samnadol/ROV_PCIe_USB_HUB/README.md

# PCIe USB Hub for Pi 5

# Images
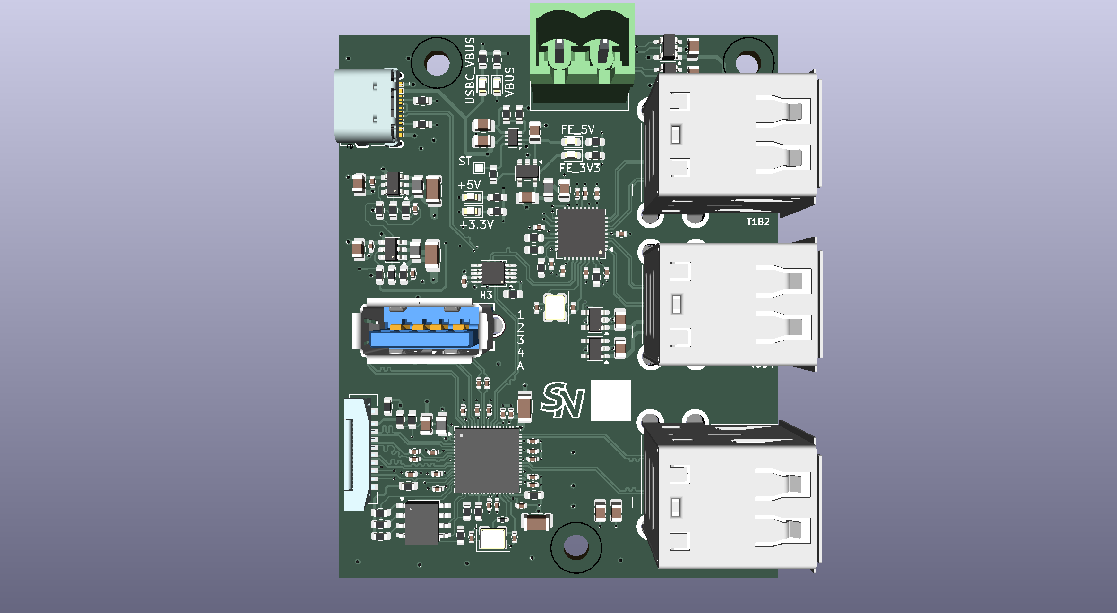
[picture p1: board_usb2514.png]
USB2514 Board
