samnadol/ROV_PCIe_USB_HUB/ROV_PCIe_USB_HUB_USB2514/parts.txt

https://www.molex.com/en-us/products/part-detail/525591652?display=pdf
https://www.pishop.us/product/pcie-flexible-cable-40mm-for-raspberry-pi-5-suitable-for-various-raspberry-pi-5-pcie-hats/

AQDYB3tn74kUOxAAGxyP+QQopcaaUm6YQ6fong==
