samnadol/ROV_PCIe_USB_HUB/ROV_PCIe_USB_HUB_FINAL/ROV_PCIE_USB_HUB_FINAL.kicad_pcb

## KiCad design ROV_PCIe_USB_HUB_FINAL/ROV_PCIE_USB_HUB_FINAL.kicad_pcb (2026-09-04)

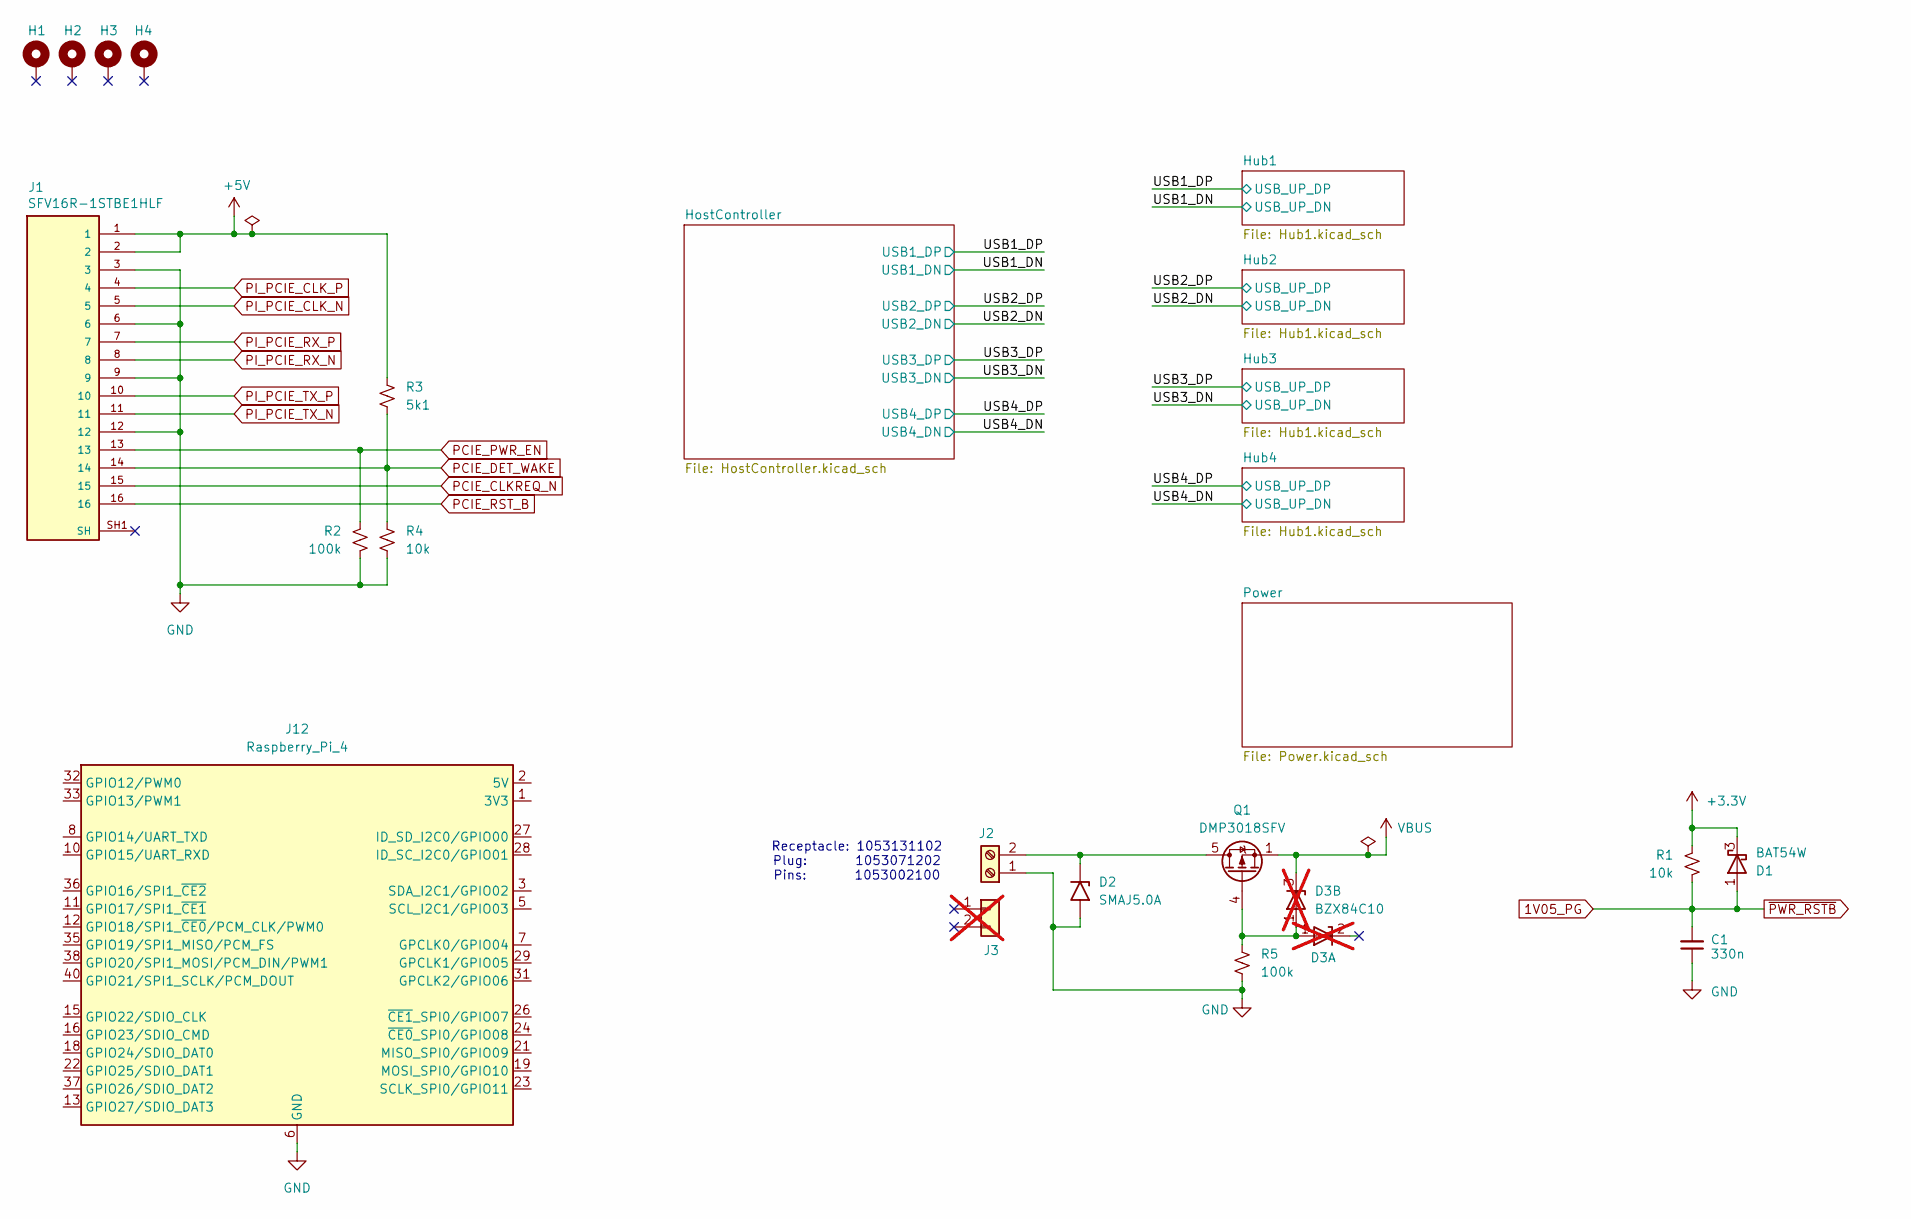
[picture p2: schematic ROV_PCIE_USB_HUB_FINAL.kicad_sch]

Parts:
C1: 330n; C_0402_1005Metric
D1: BAT54W; SOT-323_SC-70
D2: SMAJ5.0A; D_SMA; Part Number SMAJ5.0A
D3: BZX84C10; SOT-23; not fitted
H1, H2, H3, H4: MountingHole_Pad; MountingHole_2.7mm_M2.5_Pad
J1: SFV16R-1STBE1HLF; AMPHENOL_SFV16R-1STBE1HLF; PARTREV B
J2: 1053131102; Part Number 1053131102
J3: 1053071202; Part Number 1053071202; not fitted
J12: Raspberry_Pi_4; PinSocket_2x20_P2.54mm_Vertical
Q1: DMP3018SFV; Diodes_PowerDI3333-8; Part Number DMP3018SFV
R1, R4: 10k; R_0603_1608Metric
R2: 100k; R_0603_1608Metric
R3: 5k1; R_0603_1608Metric
R5: 100k; R_0603_1608Metric; Part Number RC0603FR-07100KL

Connections:
1V05_PG: C1.2, D1.1 (A), R1.2; also elsewhere on the board
+3.3V: D1.3 (K), R1.1; also elsewhere on the board
+5V: J1.1, J1.2, R3.1; also elsewhere on the board
GND: C1.1, D2.2 (A2), J1.3, J1.6, J1.9, J1.12, J2.1, J12.6 (GND), J12.9 (GND), J12.14 (GND), J12.20 (GND), J12.25 (GND), J12.30 (GND), J12.34 (GND), J12.39 (GND), R2.2, R4.2, R5.2; also elsewhere on the board
unnamed: D2.1 (A1), J2.2, Q1.5 (D)
unnamed: D3.1 (A), Q1.4 (G), R5.1
unnamed: J12.1 (3V3), J12.17 (3V3)
unnamed: J12.2 (5V), J12.4 (5V)
PCIE_CLKREQ_N: J1.15; also elsewhere on the board
PCIE_DET_WAKE: J1.14, R3.2, R4.1; also elsewhere on the board
PCIE_PWR_EN: J1.13, R2.1; also elsewhere on the board
PCIE_RST_B: J1.16; also elsewhere on the board
PI_PCIE_CLK_N: J1.5; also elsewhere on the board
PI_PCIE_CLK_P: J1.4; also elsewhere on the board
PI_PCIE_RX_N: J1.8; also elsewhere on the board
PI_PCIE_RX_P: J1.7; also elsewhere on the board
PI_PCIE_TX_N: J1.11; also elsewhere on the board
PI_PCIE_TX_P: J1.10; also elsewhere on the board
VBUS: D3.3 (K), Q1.1 (S), Q1.2 (S), Q1.3 (S); also elsewhere on the board

Notes on the sheet:
Receptacle: 1053131102 Plug: 1053071202 Pins: 1053002100

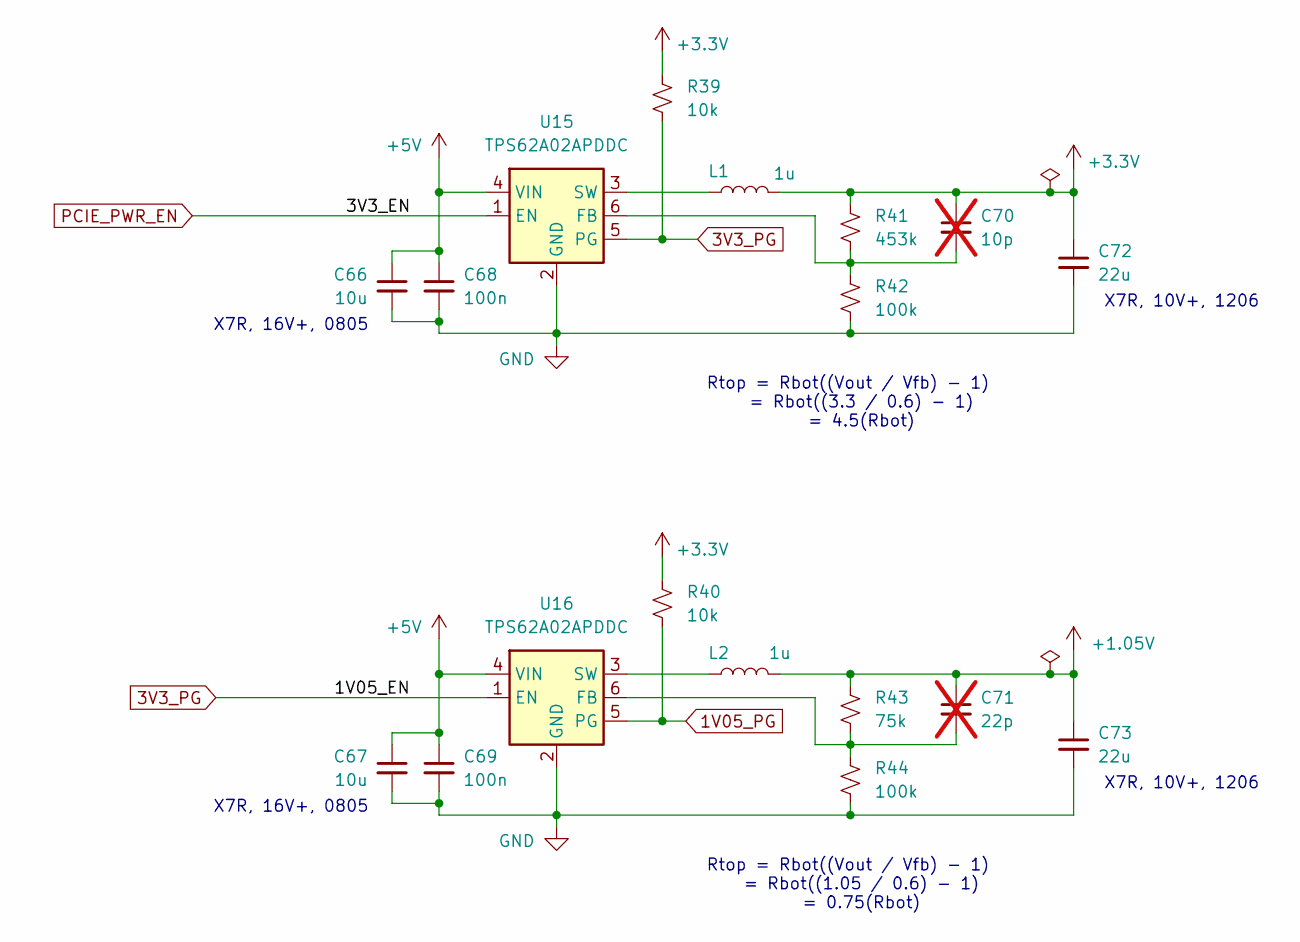
[picture p3: schematic Power.kicad_sch]

Parts:
C66, C67: 10u; C_0805_2012Metric; Part Number CC0805KRX5R8BB106
C68, C69: 100n; C_0402_1005Metric; Part Number CC0402KRX7R8BB104
C70: 10p; C_0402_1005Metric; Part Number CL05C100JB5NNNC; not fitted
C71: 22p; C_0402_1005Metric; Part Number CL05C220JB5NNNC; not fitted
C72, C73: 22u; C_1206_3216Metric; Part Number CC1206KKX5R8BB226
L1, L2: 1u; L_1008_2520Metric; Part Number DFE252012F-1R0M
R39, R40: 10k; R_0603_1608Metric; Part Number RC0603FR-0710KL
R41: 453k; R_0603_1608Metric; Part Number RC0603FR-07453KL
R42, R44: 100k; R_0603_1608Metric; Part Number RC0603FR-07100KL
R43: 75k; R_0603_1608Metric; Part Number RC0603FR-0775KL
U15, U16: TPS62A02APDDC; SOT-23-6; Part Number TPS62A02APDDC

Connections:
1V05_PG: R40.2, U16.5 (PG); also elsewhere on the board
3V3_PG: R39.2, U15.5 (PG), U16.1 (EN)
+1.05V: C71.1, C73.1, L2.2, R43.1; also elsewhere on the board
+3.3V: C70.1, C72.1, L1.2, R39.1, R40.1, R41.1; also elsewhere on the board
+5V: C66.1, C67.1, C68.1, C69.1, U15.4 (VIN), U16.4 (VIN); also elsewhere on the board
GND: C66.2, C67.2, C68.2, C69.2, C72.2, C73.2, R42.2, R44.2, U15.2 (GND), U16.2 (GND); also elsewhere on the board
unnamed: C70.2, R41.2, R42.1, U15.6 (FB)
unnamed: L1.1, U15.3 (SW)
unnamed: C71.2, R43.2, R44.1, U16.6 (FB)
unnamed: L2.1, U16.3 (SW)
PCIE_PWR_EN: U15.1 (EN); also elsewhere on the board

Notes on the sheet:
X7R, 10V+, 1206
Rtop = Rbot((Vout / Vfb) - 1) = Rbot((1.05 / 0.6) - 1) = 0.75(Rbot)
Rtop = Rbot((Vout / Vfb) - 1) = Rbot((3.3 / 0.6) - 1) = 4.5(Rbot)
X7R, 16V+, 0805

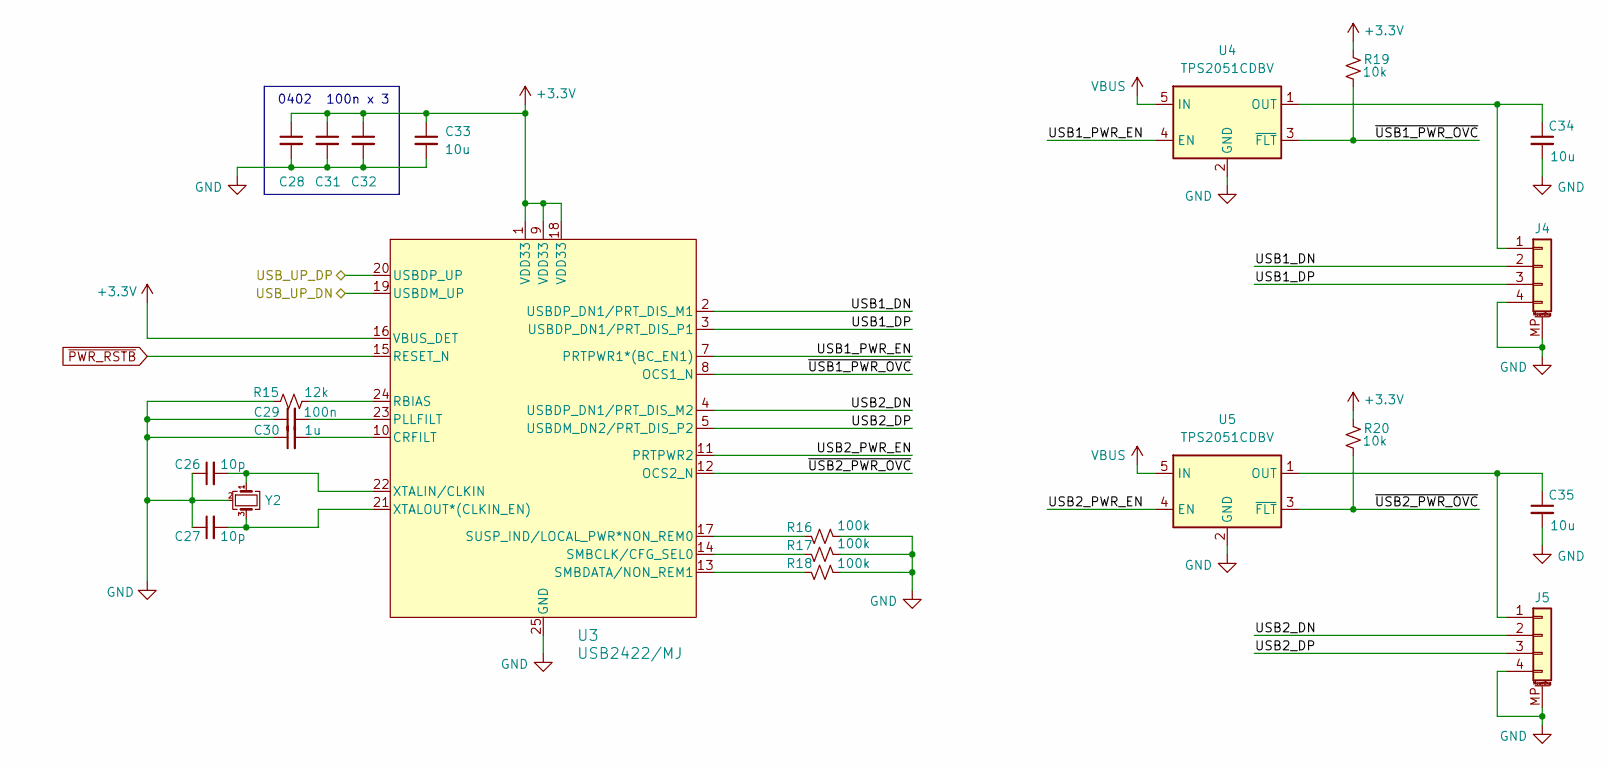
[picture p4: schematic Hub1.kicad_sch]

Parts:
C26, C27: 10p; C_0402_1005Metric
C28, C29, C31, C32: 100n; C_0402_1005Metric
C30: 1u; C_0603_1608Metric
C33: 10u; C_0805_2012Metric
C34, C35: 10u; C_0805_2012Metric; Part Number CC0805KRX5R8BB106
J4, J5: SM04B-SRSS-TB; JST_SH_SM04B-SRSS-TB_1x04-1MP_P1.00mm_Horizontal
R15: 12k; R_0603_1608Metric
R16, R17, R18: 100k; R_0603_1608Metric
R19, R20: 10k; R_0402_1005Metric
U3: USB2422/MJ; QFN-24-1EP_4x4mm_P0.5mm_EP2.5x2.5mm_ThermalVias
U4, U5: TPS2051CDBV; SOT-23-5
Y2: ECS-240-8-37B-CKY-TR; Crystal_SMD_2016-4Pin_2.0x1.6mm

Connections:
1V05_PG: U3.15 (RESET_N); also elsewhere on the board
+3.3V: C28.1, C31.1, C32.1, C33.1, R19.1, R20.1, U3.1 (VDD33), U3.9 (VDD33), U3.16 (VBUS_DET), U3.18 (VDD33); also elsewhere on the board
/Hub1/USB1_DN: J4.2, U3.2 (USBDP_DN1/PRT_DIS_M1)
/Hub1/USB1_DP: J4.3, U3.3 (USBDP_DN1/PRT_DIS_P1)
/Hub1/USB1_PWR_EN: U3.7 (PRTPWR1*(BC_EN1)), U4.4 (EN)
/Hub1/USB2_DN: J5.2, U3.4 (USBDP_DN1/PRT_DIS_M2)
/Hub1/USB2_DP: J5.3, U3.5 (USBDM_DN2/PRT_DIS_P2)
/Hub1/USB2_PWR_EN: U3.11 (PRTPWR2), U5.4 (EN)
/Hub1/~USB1_PWR_OVC: R19.2, U3.8 (OCS1_N), U4.3 (~FLT)
/Hub1/~USB2_PWR_OVC: R20.2, U3.12 (OCS2_N), U5.3 (~FLT)
/USB1_DN: U3.19 (USBDM_UP); also elsewhere on the board
/USB1_DP: U3.20 (USBDP_UP); also elsewhere on the board
GND: C26.1, C27.1, C28.2, C29.1, C30.1, C31.2, C32.2, C33.2, C34.2, C35.2, J4.4, J4.MP (MountPin), J5.4, J5.MP (MountPin), R15.1, R16.2, R17.2, R18.2, U3.25 (GND), U4.2 (GND), U5.2 (GND), Y2.2 (G), Y2.4 (G); also elsewhere on the board
unnamed: C34.1, J4.1, U4.1 (OUT)
unnamed: C35.1, J5.1, U5.1 (OUT)
unnamed: C30.2, U3.10 (CRFILT)
unnamed: C29.2, U3.23 (PLLFILT)
unnamed: R15.2, U3.24 (RBIAS)
unnamed: R17.1, U3.14 (SMBCLK/CFG_SEL0)
unnamed: R18.1, U3.13 (SMBDATA/NON_REM1)
unnamed: R16.1, U3.17 (SUSP_IND/LOCAL_PWR*NON_REM0)
unnamed: C26.2, U3.22 (XTALIN/CLKIN), Y2.1
unnamed: C27.2, U3.21 (XTALOUT*(CLKIN_EN)), Y2.3
VBUS: U4.5 (IN), U5.5 (IN); also elsewhere on the board

Parts of its further copies:
C36, C37, C46, C47, C56, C57: 10p; C_0402_1005Metric
C38, C39, C41, C42, C48, C49, C51, C52, C58, C59, C61, C62: 100n; C_0402_1005Metric
C40, C50, C60: 1u; C_0603_1608Metric
C43, C53, C63: 10u; C_0805_2012Metric
C44, C45, C54, C55, C64, C65: 10u; C_0805_2012Metric; Part Number CC0805KRX5R8BB106
J6, J7, J8, J9, J10, J11: SM04B-SRSS-TB; JST_SH_SM04B-SRSS-TB_1x04-1MP_P1.00mm_Horizontal
R21, R27, R33: 12k; R_0603_1608Metric
R22, R23, R24, R28, R29, R30, R34, R35, R36: 100k; R_0603_1608Metric
R25, R26, R31, R32, R37, R38: 10k; R_0402_1005Metric
U6, U9, U12: USB2422/MJ; QFN-24-1EP_4x4mm_P0.5mm_EP2.5x2.5mm_ThermalVias
U7, U8, U10, U11, U13, U14: TPS2051CDBV; SOT-23-5
Y3, Y4, Y5: ECS-240-8-37B-CKY-TR; Crystal_SMD_2016-4Pin_2.0x1.6mm

Connections of its further copies:
1V05_PG: U6.15 (RESET_N), U9.15 (RESET_N), U12.15 (RESET_N); also elsewhere on the board
+3.3V: C38.1, C41.1, C42.1, C43.1, C48.1, C51.1, C52.1, C53.1, C58.1, C61.1, C62.1, C63.1, R25.1, R26.1, R31.1, R32.1, R37.1, R38.1, U6.1 (VDD33), U6.9 (VDD33), U6.16 (VBUS_DET), U6.18 (VDD33), U9.1 (VDD33), U9.9 (VDD33), U9.16 (VBUS_DET), U9.18 (VDD33), U12.1 (VDD33), U12.9 (VDD33), U12.16 (VBUS_DET), U12.18 (VDD33); also elsewhere on the board
/Hub2/USB1_DN: J6.2, U6.2 (USBDP_DN1/PRT_DIS_M1)
/Hub2/USB1_DP: J6.3, U6.3 (USBDP_DN1/PRT_DIS_P1)
/Hub2/USB1_PWR_EN: U6.7 (PRTPWR1*(BC_EN1)), U7.4 (EN)
/Hub2/USB2_DN: J7.2, U6.4 (USBDP_DN1/PRT_DIS_M2)
/Hub2/USB2_DP: J7.3, U6.5 (USBDM_DN2/PRT_DIS_P2)
/Hub2/USB2_PWR_EN: U6.11 (PRTPWR2), U8.4 (EN)
/Hub2/~USB1_PWR_OVC: R25.2, U6.8 (OCS1_N), U7.3 (~FLT)
/Hub2/~USB2_PWR_OVC: R26.2, U6.12 (OCS2_N), U8.3 (~FLT)
/Hub3/USB1_DN: J8.2, U9.2 (USBDP_DN1/PRT_DIS_M1)
/Hub3/USB1_DP: J8.3, U9.3 (USBDP_DN1/PRT_DIS_P1)
/Hub3/USB1_PWR_EN: U9.7 (PRTPWR1*(BC_EN1)), U10.4 (EN)
/Hub3/USB2_DN: J9.2, U9.4 (USBDP_DN1/PRT_DIS_M2)
/Hub3/USB2_DP: J9.3, U9.5 (USBDM_DN2/PRT_DIS_P2)
/Hub3/USB2_PWR_EN: U9.11 (PRTPWR2), U11.4 (EN)
/Hub3/~USB1_PWR_OVC: R31.2, U9.8 (OCS1_N), U10.3 (~FLT)
/Hub3/~USB2_PWR_OVC: R32.2, U9.12 (OCS2_N), U11.3 (~FLT)
/Hub4/USB1_DN: J10.2, U12.2 (USBDP_DN1/PRT_DIS_M1)
/Hub4/USB1_DP: J10.3, U12.3 (USBDP_DN1/PRT_DIS_P1)
/Hub4/USB1_PWR_EN: U12.7 (PRTPWR1*(BC_EN1)), U13.4 (EN)
/Hub4/USB2_DN: J11.2, U12.4 (USBDP_DN1/PRT_DIS_M2)
/Hub4/USB2_DP: J11.3, U12.5 (USBDM_DN2/PRT_DIS_P2)
/Hub4/USB2_PWR_EN: U12.11 (PRTPWR2), U14.4 (EN)
/Hub4/~USB1_PWR_OVC: R37.2, U12.8 (OCS1_N), U13.3 (~FLT)
/Hub4/~USB2_PWR_OVC: R38.2, U12.12 (OCS2_N), U14.3 (~FLT)
/USB2_DN: U6.19 (USBDM_UP); also elsewhere on the board
/USB2_DP: U6.20 (USBDP_UP); also elsewhere on the board
/USB3_DN: U9.19 (USBDM_UP); also elsewhere on the board
/USB3_DP: U9.20 (USBDP_UP); also elsewhere on the board
/USB4_DN: U12.19 (USBDM_UP); also elsewhere on the board
/USB4_DP: U12.20 (USBDP_UP); also elsewhere on the board
GND: C36.1, C37.1, C38.2, C39.1, C40.1, C41.2, C42.2, C43.2, C44.2, C45.2, C46.1, C47.1, C48.2, C49.1, C50.1, C51.2, C52.2, C53.2, C54.2, C55.2, C56.1, C57.1, C58.2, C59.1, C60.1, C61.2, C62.2, C63.2, C64.2, C65.2, J6.4, J6.MP (MountPin), J7.4, J7.MP (MountPin), J8.4, J8.MP (MountPin), J9.4, J9.MP (MountPin), J10.4, J10.MP (MountPin), J11.4, J11.MP (MountPin), R21.1, R22.2, R23.2, R24.2, R27.1, R28.2, R29.2, R30.2, R33.1, R34.2, R35.2, R36.2, U6.25 (GND), U7.2 (GND), U8.2 (GND), U9.25 (GND), U10.2 (GND), U11.2 (GND), U12.25 (GND), U13.2 (GND), U14.2 (GND), Y3.2 (G), Y3.4 (G), Y4.2 (G), Y4.4 (G), Y5.2 (G), Y5.4 (G); also elsewhere on the board
unnamed: C44.1, J6.1, U7.1 (OUT)
unnamed: C45.1, J7.1, U8.1 (OUT)
unnamed: C54.1, J8.1, U10.1 (OUT)
unnamed: C55.1, J9.1, U11.1 (OUT)
unnamed: C64.1, J10.1, U13.1 (OUT)
unnamed: C65.1, J11.1, U14.1 (OUT)
unnamed: C40.2, U6.10 (CRFILT)
unnamed: C39.2, U6.23 (PLLFILT)
unnamed: R21.2, U6.24 (RBIAS)
unnamed: R23.1, U6.14 (SMBCLK/CFG_SEL0)
unnamed: R24.1, U6.13 (SMBDATA/NON_REM1)
unnamed: R22.1, U6.17 (SUSP_IND/LOCAL_PWR*NON_REM0)
unnamed: C36.2, U6.22 (XTALIN/CLKIN), Y3.1
unnamed: C37.2, U6.21 (XTALOUT*(CLKIN_EN)), Y3.3
unnamed: C50.2, U9.10 (CRFILT)
unnamed: C49.2, U9.23 (PLLFILT)
unnamed: R27.2, U9.24 (RBIAS)
unnamed: R29.1, U9.14 (SMBCLK/CFG_SEL0)
unnamed: R30.1, U9.13 (SMBDATA/NON_REM1)
unnamed: R28.1, U9.17 (SUSP_IND/LOCAL_PWR*NON_REM0)
unnamed: C46.2, U9.22 (XTALIN/CLKIN), Y4.1
unnamed: C47.2, U9.21 (XTALOUT*(CLKIN_EN)), Y4.3
unnamed: C60.2, U12.10 (CRFILT)
unnamed: C59.2, U12.23 (PLLFILT)
unnamed: R33.2, U12.24 (RBIAS)
unnamed: R35.1, U12.14 (SMBCLK/CFG_SEL0)
unnamed: R36.1, U12.13 (SMBDATA/NON_REM1)
unnamed: R34.1, U12.17 (SUSP_IND/LOCAL_PWR*NON_REM0)
unnamed: C56.2, U12.22 (XTALIN/CLKIN), Y5.1
unnamed: C57.2, U12.21 (XTALOUT*(CLKIN_EN)), Y5.3
VBUS: U7.5 (IN), U8.5 (IN), U10.5 (IN), U11.5 (IN), U13.5 (IN), U14.5 (IN); also elsewhere on the board

Notes on the sheet:
0402
100n x 3

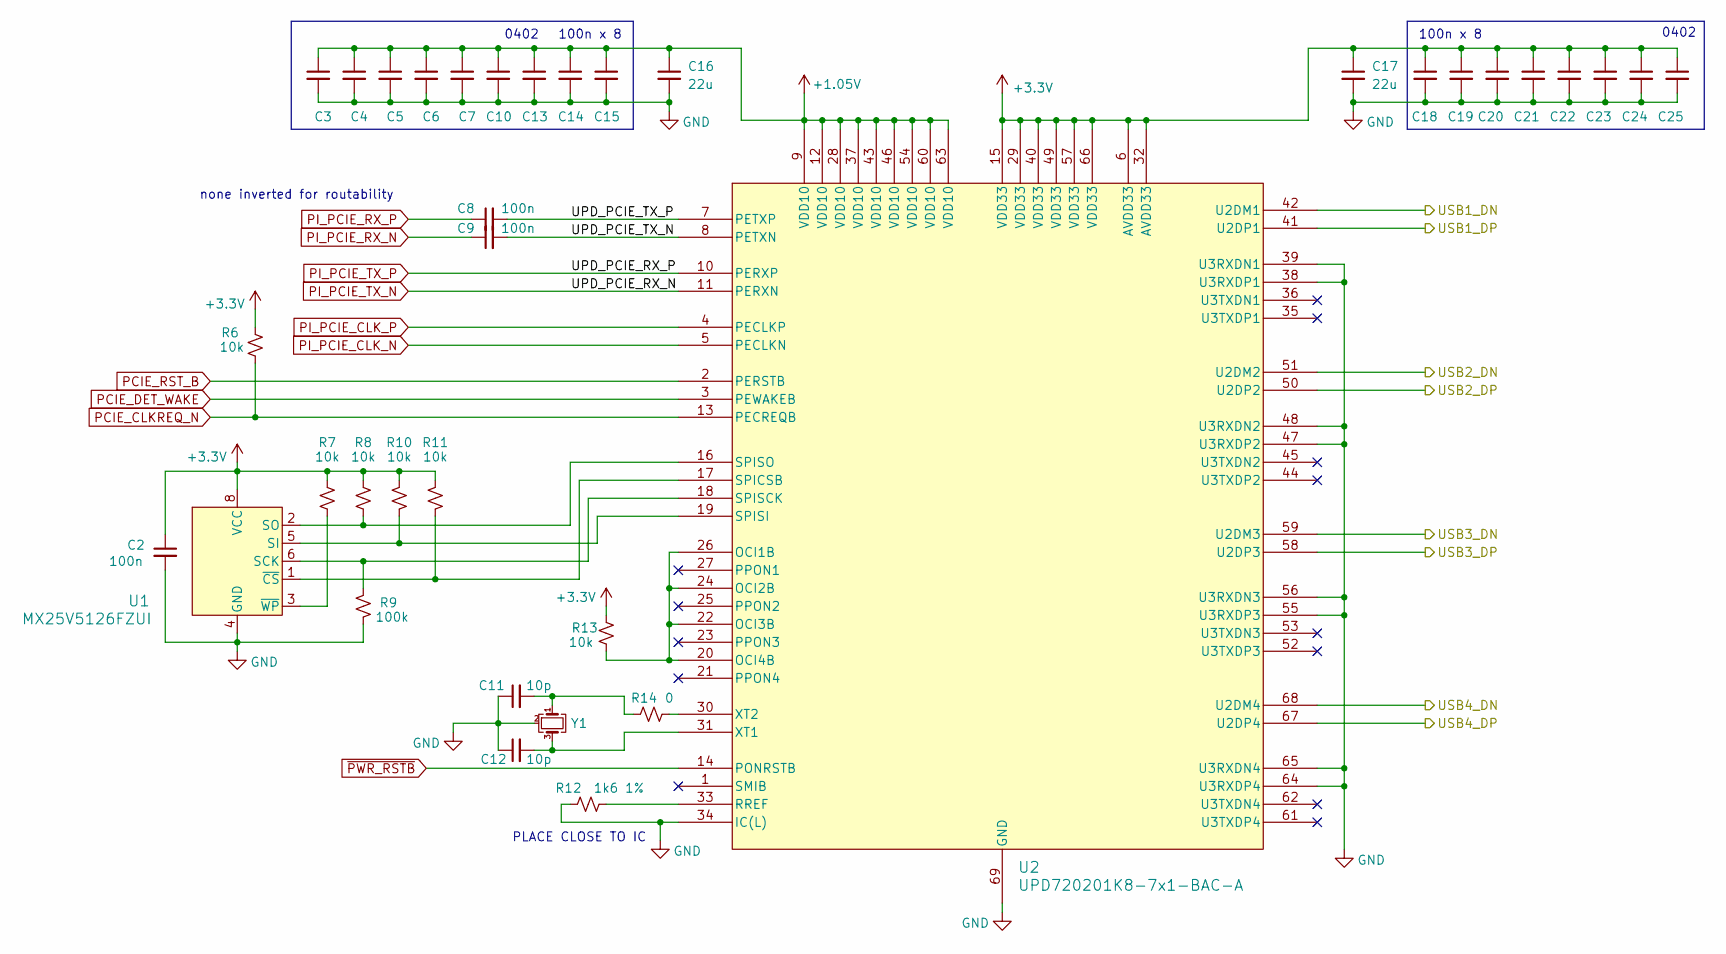
[picture p5: schematic HostController.kicad_sch]

Parts:
C2, C3, C4, C5, C6, C7, C8, C9, C10, C13, C14, C15, C18, C19, C20, C21, C22, C23, C24, C25: 100n; C_0402_1005Metric
C11, C12: 10p; C_0402_1005Metric
C16, C17: 22u; C_1206_3216Metric
R6, R7, R8, R10, R11, R13: 10k; R_0402_1005Metric
R9: 100k; R_0603_1608Metric
R12: 1k6 1%; R_0603_1608Metric
R14: 0; R_0402_1005Metric
U1: MX25V5126FZUI; Winbond_USON-8-1EP_3x2mm_P0.5mm_EP0.2x1.6mm
U2: UPD720201K8-7x1-BAC-A; QFN-68-1EP_8x8mm_P0.4mm_EP6.2x6.2mm
Y1: ECS-240-8-37B-CKY-TR; Crystal_SMD_2016-4Pin_2.0x1.6mm

Connections:
1V05_PG: U2.14 (PONRSTB); also elsewhere on the board
+1.05V: C3.1, C4.1, C5.1, C6.1, C7.1, C10.1, C13.1, C14.1, C15.1, C16.1, U2.9 (VDD10), U2.12 (VDD10), U2.28 (VDD10), U2.37 (VDD10), U2.43 (VDD10), U2.46 (VDD10), U2.54 (VDD10), U2.60 (VDD10), U2.63 (VDD10); also elsewhere on the board
+3.3V: C2.1, C17.1, C18.1, C19.1, C20.1, C21.1, C22.1, C23.1, C24.1, C25.1, R6.1, R7.1, R8.1, R10.1, R11.1, R13.1, U1.8 (VCC), U2.6 (AVDD33), U2.15 (VDD33), U2.29 (VDD33), U2.32 (AVDD33), U2.40 (VDD33), U2.49 (VDD33), U2.57 (VDD33), U2.66 (VDD33); also elsewhere on the board
/HostController/UPD_PCIE_TX_N: C9.2, U2.8 (PETXN)
/HostController/UPD_PCIE_TX_P: C8.2, U2.7 (PETXP)
/USB1_DN: U2.42 (U2DM1); also elsewhere on the board
/USB1_DP: U2.41 (U2DP1); also elsewhere on the board
/USB2_DN: U2.51 (U2DM2); also elsewhere on the board
/USB2_DP: U2.50 (U2DP2); also elsewhere on the board
/USB3_DN: U2.59 (U2DM3); also elsewhere on the board
/USB3_DP: U2.58 (U2DP3); also elsewhere on the board
/USB4_DN: U2.68 (U2DM4); also elsewhere on the board
/USB4_DP: U2.67 (U2DP4); also elsewhere on the board
GND: C2.2, C3.2, C4.2, C5.2, C6.2, C7.2, C10.2, C11.1, C12.1, C13.2, C14.2, C15.2, C16.2, C17.2, C18.2, C19.2, C20.2, C21.2, C22.2, C23.2, C24.2, C25.2, R9.2, R12.1, U1.4 (GND), U1.9 (EP), U2.34 (IC(L)), U2.38 (U3RXDP1), U2.39 (U3RXDN1), U2.47 (U3RXDP2), U2.48 (U3RXDN2), U2.55 (U3RXDP3), U2.56 (U3RXDN3), U2.64 (U3RXDP4), U2.65 (U3RXDN4), U2.69 (GND), Y1.2 (G), Y1.4 (G); also elsewhere on the board
unnamed: C11.2, R14.1, Y1.1
unnamed: R9.1, U1.6 (SCK), U2.18 (SPISCK)
unnamed: R10.2, U1.5 (SI), U2.19 (SPISI)
unnamed: R8.2, U1.2 (SO), U2.16 (SPISO)
unnamed: R11.2, U1.1 (~CS), U2.17 (SPICSB)
unnamed: R7.2, U1.3 (~WP)
unnamed: R13.2, U2.20 (OCI4B), U2.22 (OCI3B), U2.24 (OCI2B), U2.26 (OCI1B)
unnamed: R12.2, U2.33 (RREF)
unnamed: C12.2, U2.31 (XT1), Y1.3
unnamed: R14.2, U2.30 (XT2)
PCIE_CLKREQ_N: R6.2, U2.13 (PECREQB); also elsewhere on the board
PCIE_DET_WAKE: U2.3 (PEWAKEB); also elsewhere on the board
PCIE_RST_B: U2.2 (PERSTB); also elsewhere on the board
PI_PCIE_CLK_N: U2.5 (PECLKN); also elsewhere on the board
PI_PCIE_CLK_P: U2.4 (PECLKP); also elsewhere on the board
PI_PCIE_RX_N: C9.1; also elsewhere on the board
PI_PCIE_RX_P: C8.1; also elsewhere on the board
PI_PCIE_TX_N: U2.11 (PERXN); also elsewhere on the board
PI_PCIE_TX_P: U2.10 (PERXP); also elsewhere on the board

Notes on the sheet:
100n x 8
0402
none inverted for routability
PLACE CLOSE TO IC

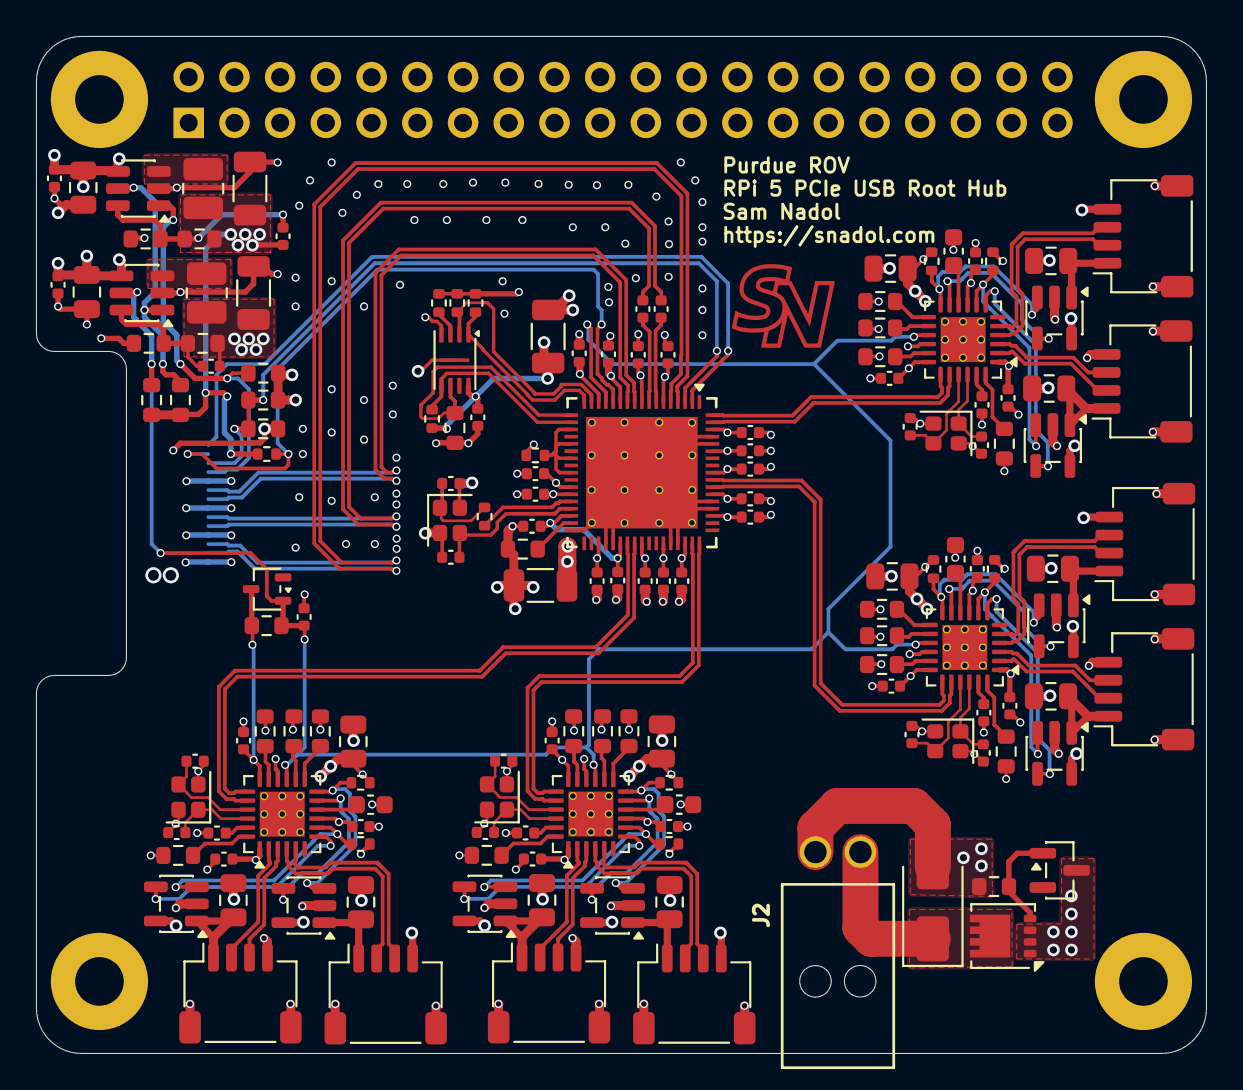
[picture p6: board ROV_PCIE_USB_HUB_FINAL.kicad_pcb from above]

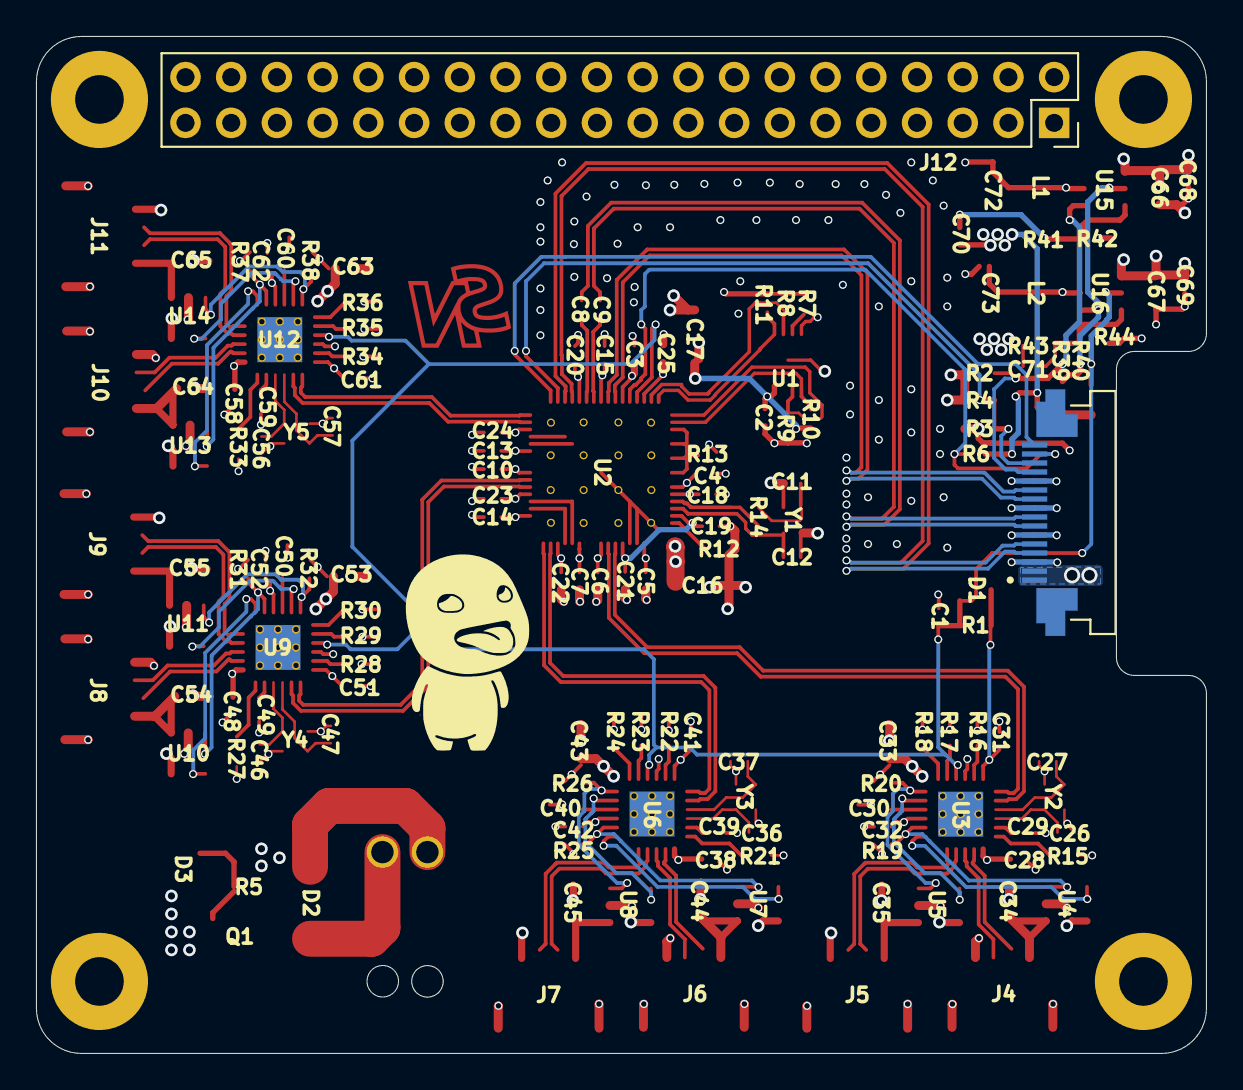
[picture p7: board ROV_PCIE_USB_HUB_FINAL.kicad_pcb from below]

Board: 4 copper layers, 65.0 x 56.5 mm, 159 parts (2 on the bottom side), 117 nets.
