samnadol/ROV_PCIe_USB_HUB/ROV_PCIe_USB_HUB_USB2514/rov_usb.kicad_pcb

## KiCad design ROV_PCIe_USB_HUB_USB2514/rov_usb.kicad_pcb (2026-08-31)

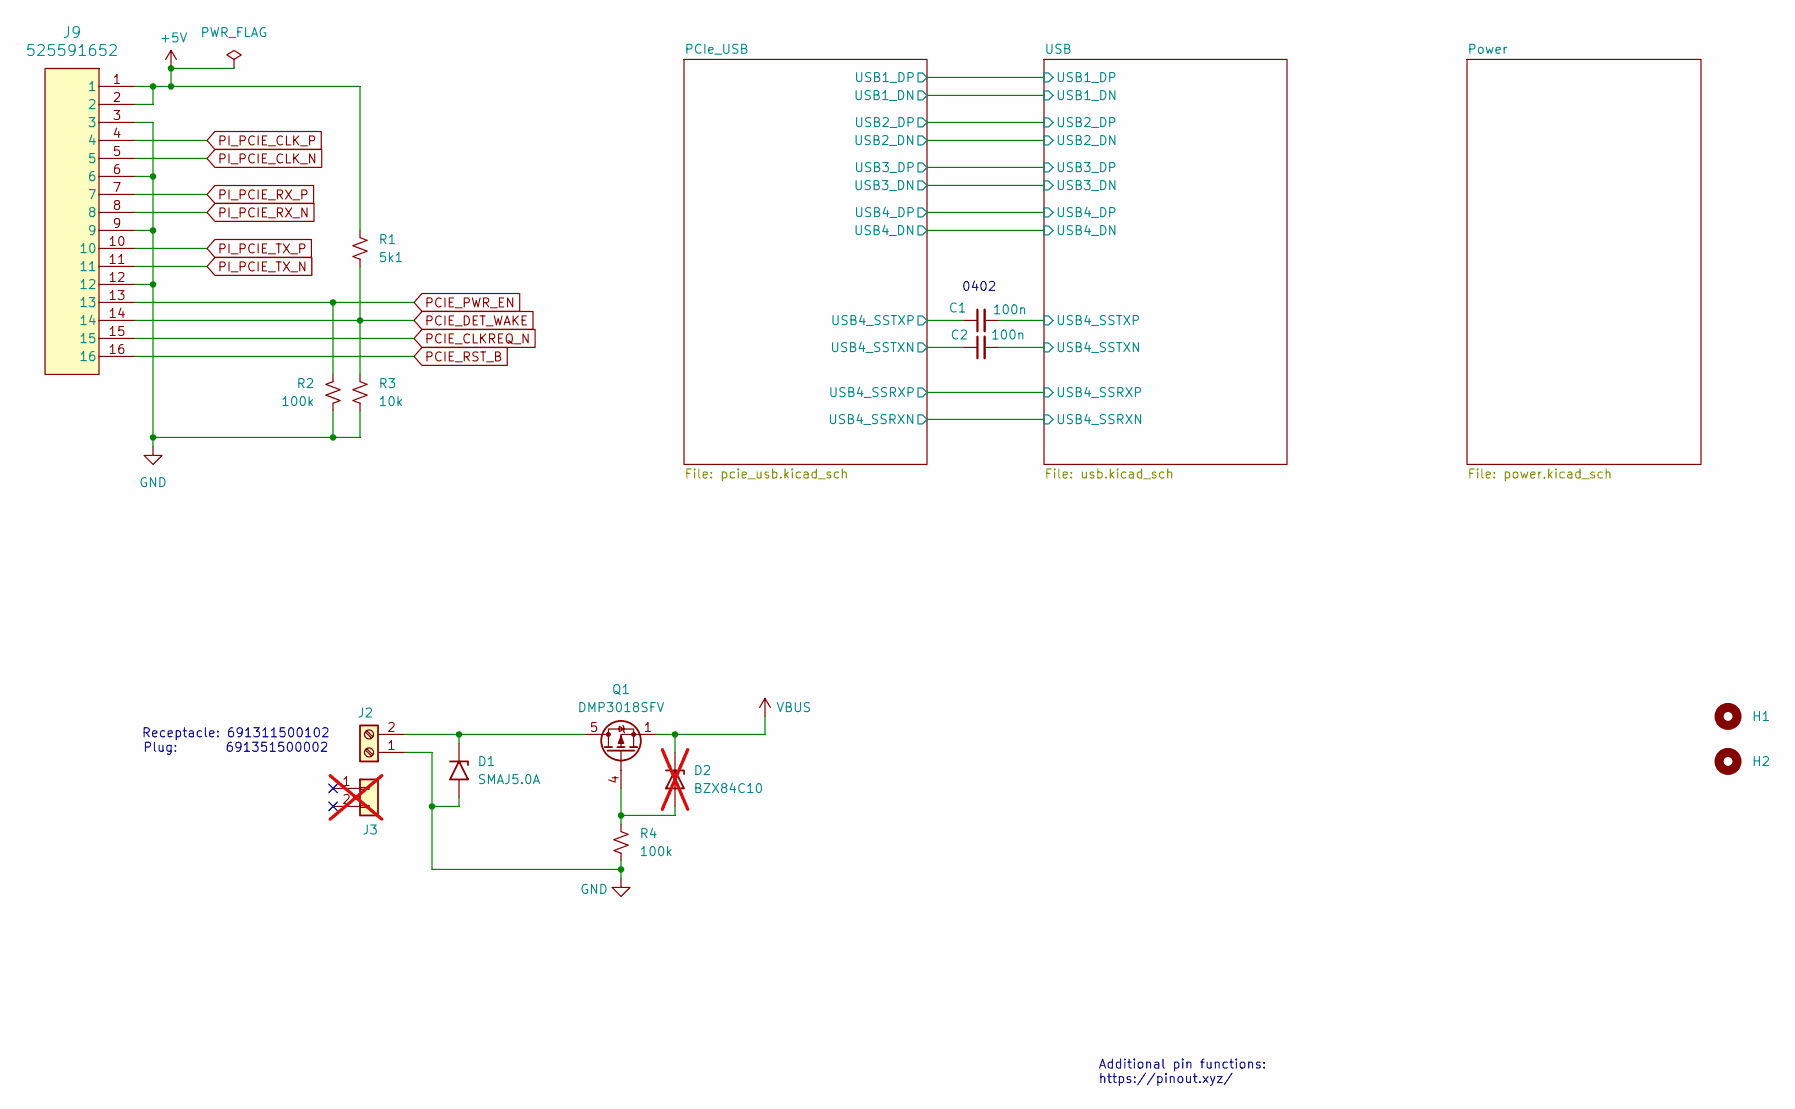
[picture p8: schematic rov_usb.kicad_sch]

Parts:
C1, C2: 100n; C_0402_1005Metric; Part Number CC0402KRX7R8BB104
D1: SMAJ5.0A; D_SMA; Part Number SMAJ5.0A
D2: BZX84C10; D_0402_1005Metric; not fitted
H1, H2: MountingHole; MountingHole_3.2mm_M3
J2: 691311500102; J_Wurth_WR-TBL_691311500102; Part Number 691311500102
J3: 691351500002; Part Number 691351500002; not fitted
J9: 525591652
Q1: DMP3018SFV; Diodes_PowerDI3333-8; Part Number DMP3018SFV
R1: 5k1; R_0603_1608Metric; Part Number RC0603FR-075K1L
R2, R4: 100k; R_0603_1608Metric; Part Number RC0603FR-07100KL
R3: 10k; R_0603_1608Metric; Part Number RC0603FR-0710KL

Connections:
+5V: J9.1, J9.2, R1.1; also elsewhere on the board
/PCIe_USB/USB4_SSTXN: C2.1; also elsewhere on the board
/PCIe_USB/USB4_SSTXP: C1.1; also elsewhere on the board
/USB/USB4_SSTXN: C2.2; also elsewhere on the board
/USB/USB4_SSTXP: C1.2; also elsewhere on the board
GND: D1.2 (A2), J2.1, J9.3, J9.6, J9.9, J9.12, R2.2, R3.2, R4.2; also elsewhere on the board
unnamed: D1.1 (A1), J2.2, Q1.5 (D)
unnamed: D2.2 (A), Q1.4 (G), R4.1
PCIE_CLKREQ_N: J9.15; also elsewhere on the board
PCIE_DET_WAKE: J9.14, R1.2, R3.1; also elsewhere on the board
PCIE_PWR_EN: J9.13, R2.1; also elsewhere on the board
PCIE_RST_B: J9.16; also elsewhere on the board
PI_PCIE_CLK_N: J9.5; also elsewhere on the board
PI_PCIE_CLK_P: J9.4; also elsewhere on the board
PI_PCIE_RX_N: J9.8; also elsewhere on the board
PI_PCIE_RX_P: J9.7; also elsewhere on the board
PI_PCIE_TX_N: J9.11; also elsewhere on the board
PI_PCIE_TX_P: J9.10; also elsewhere on the board
VBUS: D2.1 (K), Q1.1 (S), Q1.2 (S), Q1.3 (S); also elsewhere on the board

Notes on the sheet:
Additional pin functions: https://pinout.xyz/
Receptacle: 691311500102 Plug: 691351500002
0402
