samnadol/ROV_PCIe_USB_HUB/ROV_PCIe_USB_HUB_USB2514/rov_usb.kicad_pcb

## KiCad design ROV_PCIe_USB_HUB_USB2514/rov_usb.kicad_pcb (continued)

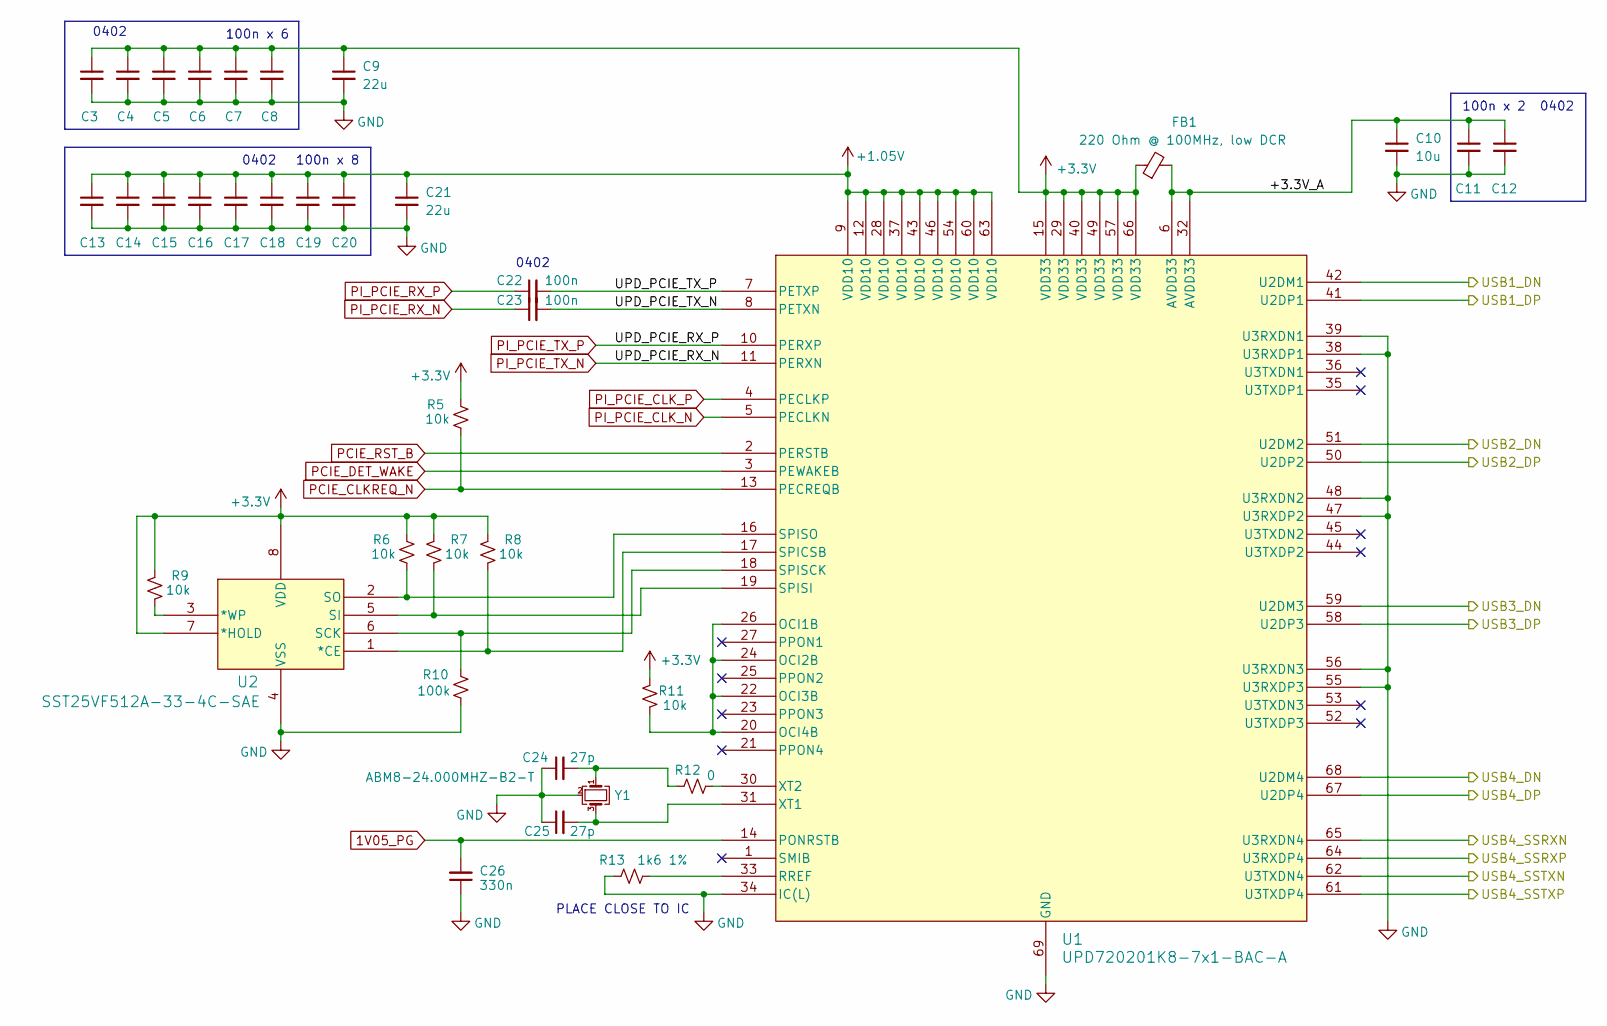
[picture p9: schematic pcie_usb.kicad_sch]

Parts:
C3, C4, C5, C6, C7, C8, C11, C12, C13, C14, C15, C16, C17, C18, C19, C20, C22, C23: 100n; C_0402_1005Metric; Part Number CC0402KRX7R8BB104
C9, C21: 22u; C_1206_3216Metric; Part Number CC1206KKX5R8BB226
C10: 10u; C_0805_2012Metric; Part Number CC0805KRX5R8BB106
C24, C25: 27p; C_0402_1005Metric; Part Number CC0402JRNPO9BN270
C26: 330n; C_0402_1005Metric; Part Number CC0402KPX5R6BB334
FB1: 220 Ohm @ 100MHz, low DCR; L_0805_2012Metric; Part Number BLM21PG221SN1D
R5, R6, R7, R8, R9, R11: 10k; R_0603_1608Metric; Part Number RC0603FR-0710KL
R10: 100k; R_0603_1608Metric; Part Number RC0603FR-07100KL
R12: 0; R_0402_1005Metric; Part Number RC0402JR-070RL
R13: 1k6 1%; R_0603_1608Metric; Part Number RC0603FR-071K6L
U1: UPD720201K8-7x1-BAC-A; QFN-68-1EP_8x8mm_P0.4mm_EP6.2x6.2mm
U2: SST25VF512A-33-4C-SAE; SOIC-8_3.9x4.9mm_P1.27mm
Y1: ABM8-24.000MHZ-B2-T; Crystal_SMD_3225-4Pin_3.2x2.5mm; Part Number ABM8-24.000MHZ-B2-T

Connections:
1V05_PG: C26.2, U1.14 (PONRSTB); also elsewhere on the board
+1.05V: C13.1, C14.1, C15.1, C16.1, C17.1, C18.1, C19.1, C20.1, C21.1, U1.9 (VDD10), U1.12 (VDD10), U1.28 (VDD10), U1.37 (VDD10), U1.43 (VDD10), U1.46 (VDD10), U1.54 (VDD10), U1.60 (VDD10), U1.63 (VDD10); also elsewhere on the board
+3.3V: C3.1, C4.1, C5.1, C6.1, C7.1, C8.1, C9.1, FB1.1, R5.1, R6.1, R7.1, R8.1, R9.1, R11.1, U1.15 (VDD33), U1.29 (VDD33), U1.40 (VDD33), U1.49 (VDD33), U1.57 (VDD33), U1.66 (VDD33), U2.7 (*HOLD), U2.8 (VDD); also elsewhere on the board
/PCIe_USB/+3.3V_A: C10.1, C11.1, C12.1, FB1.2, U1.6 (AVDD33), U1.32 (AVDD33)
/PCIe_USB/UPD_PCIE_TX_N: C23.2, U1.8 (PETXN)
/PCIe_USB/UPD_PCIE_TX_P: C22.2, U1.7 (PETXP)
/PCIe_USB/USB1_DN: U1.42 (U2DM1); also elsewhere on the board
/PCIe_USB/USB1_DP: U1.41 (U2DP1); also elsewhere on the board
/PCIe_USB/USB2_DN: U1.51 (U2DM2); also elsewhere on the board
/PCIe_USB/USB2_DP: U1.50 (U2DP2); also elsewhere on the board
/PCIe_USB/USB3_DN: U1.59 (U2DM3); also elsewhere on the board
/PCIe_USB/USB3_DP: U1.58 (U2DP3); also elsewhere on the board
/PCIe_USB/USB4_DN: U1.68 (U2DM4); also elsewhere on the board
/PCIe_USB/USB4_DP: U1.67 (U2DP4); also elsewhere on the board
/PCIe_USB/USB4_SSRXN: U1.65 (U3RXDN4); also elsewhere on the board
/PCIe_USB/USB4_SSRXP: U1.64 (U3RXDP4); also elsewhere on the board
/PCIe_USB/USB4_SSTXN: U1.62 (U3TXDN4); also elsewhere on the board
/PCIe_USB/USB4_SSTXP: U1.61 (U3TXDP4); also elsewhere on the board
GND: C3.2, C4.2, C5.2, C6.2, C7.2, C8.2, C9.2, C10.2, C11.2, C12.2, C13.2, C14.2, C15.2, C16.2, C17.2, C18.2, C19.2, C20.2, C21.2, C24.1, C25.1, C26.1, R10.2, R13.1, U1.34 (IC(L)), U1.38 (U3RXDP1), U1.39 (U3RXDN1), U1.47 (U3RXDP2), U1.48 (U3RXDN2), U1.55 (U3RXDP3), U1.56 (U3RXDN3), U1.69 (GND), U2.4 (VSS), Y1.2 (G), Y1.4 (G); also elsewhere on the board
unnamed: C24.2, R12.1, Y1.1
unnamed: R11.2, U1.20 (OCI4B), U1.22 (OCI3B), U1.24 (OCI2B), U1.26 (OCI1B)
unnamed: R13.2, U1.33 (RREF)
unnamed: R8.2, U1.17 (SPICSB), U2.1 (*CE)
unnamed: R10.1, U1.18 (SPISCK), U2.6 (SCK)
unnamed: R7.2, U1.19 (SPISI), U2.5 (SI)
unnamed: R6.2, U1.16 (SPISO), U2.2 (SO)
unnamed: C25.2, U1.31 (XT1), Y1.3
unnamed: R12.2, U1.30 (XT2)
unnamed: R9.2, U2.3 (*WP)
PCIE_CLKREQ_N: R5.2, U1.13 (PECREQB); also elsewhere on the board
PCIE_DET_WAKE: U1.3 (PEWAKEB); also elsewhere on the board
PCIE_RST_B: U1.2 (PERSTB); also elsewhere on the board
PI_PCIE_CLK_N: U1.5 (PECLKN); also elsewhere on the board
PI_PCIE_CLK_P: U1.4 (PECLKP); also elsewhere on the board
PI_PCIE_RX_N: C23.1; also elsewhere on the board
PI_PCIE_RX_P: C22.1; also elsewhere on the board
PI_PCIE_TX_N: U1.11 (PERXN); also elsewhere on the board
PI_PCIE_TX_P: U1.10 (PERXP); also elsewhere on the board

Notes on the sheet:
0402
100n x 6
100n x 2
PLACE CLOSE TO IC
100n x 8

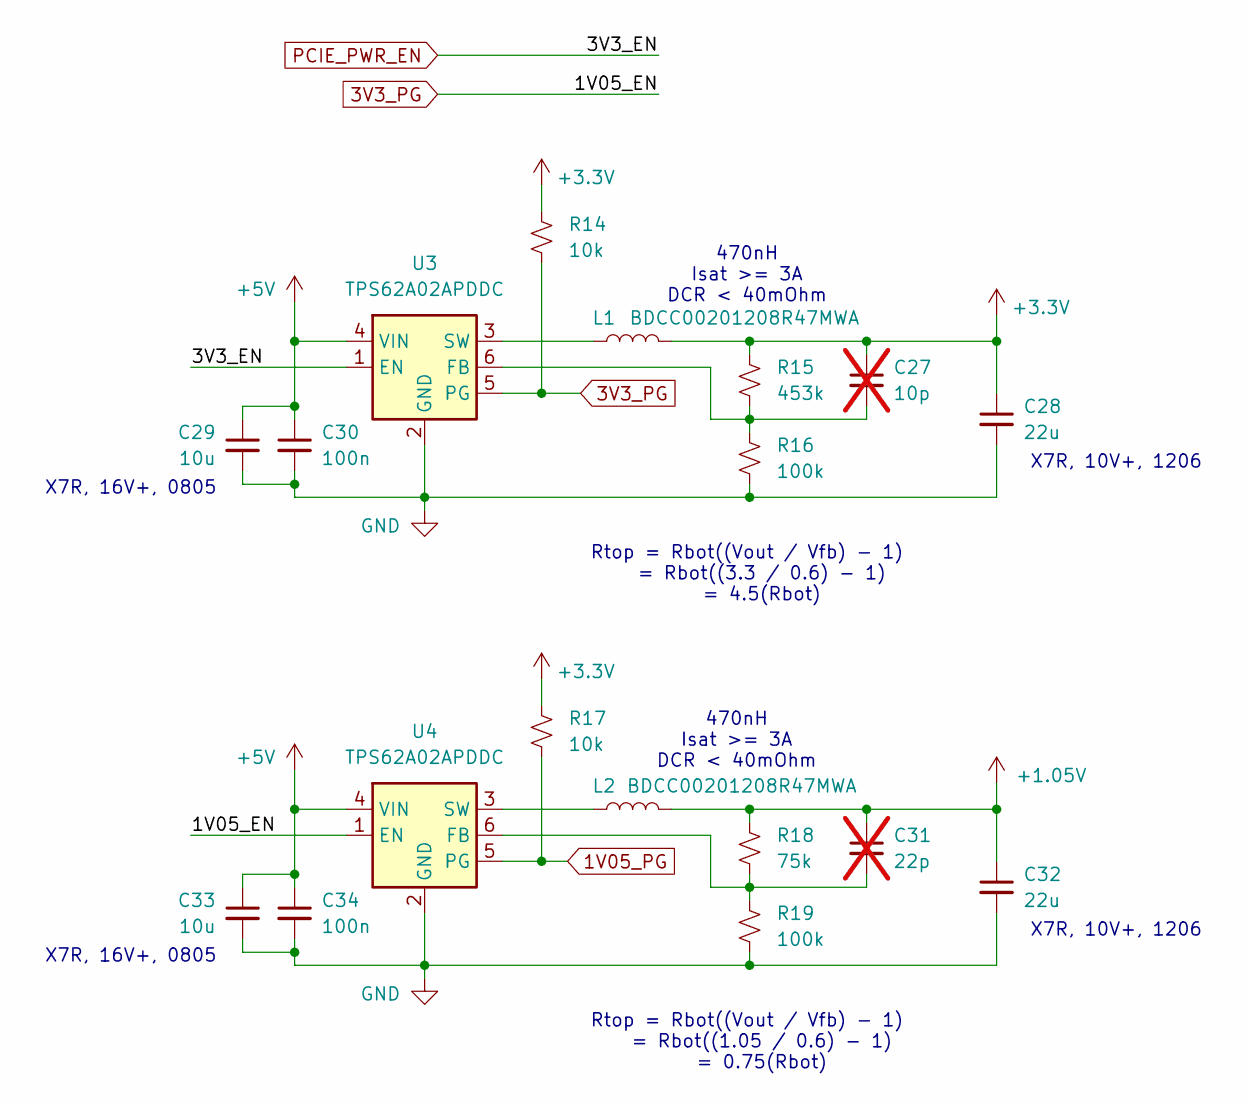
[picture p10: schematic power.kicad_sch]

Parts:
C27: 10p; C_0402_1005Metric; Part Number CL05C100JB5NNNC; not fitted
C28, C32: 22u; C_1206_3216Metric; Part Number CC1206KKX5R8BB226
C29, C33: 10u; C_0805_2012Metric; Part Number CC0805KRX5R8BB106
C30, C34: 100n; C_0402_1005Metric; Part Number CC0402KRX7R8BB104
C31: 22p; C_0402_1005Metric; Part Number CL05C220JB5NNNC; not fitted
L1, L2: BDCC00201208R47MWA; L_0805_2012Metric; Part Number BDCC00201208R47MWA
R14, R17: 10k; R_0603_1608Metric; Part Number RC0603FR-0710KL
R15: 453k; R_0603_1608Metric; Part Number RC0603FR-07453KL
R16, R19: 100k; R_0603_1608Metric; Part Number RC0603FR-07100KL
R18: 75k; R_0603_1608Metric; Part Number RC0603FR-0775KL
U3, U4: TPS62A02APDDC; SOT-23-6; Part Number TPS62A02APDDC

Connections:
1V05_PG: R17.2, U4.5 (PG); also elsewhere on the board
3V3_PG: R14.2, U3.5 (PG), U4.1 (EN)
+1.05V: C31.1, C32.1, L2.2, R18.1; also elsewhere on the board
+3.3V: C27.1, C28.1, L1.2, R14.1, R15.1, R17.1; also elsewhere on the board
+5V: C29.1, C30.1, C33.1, C34.1, U3.4 (VIN), U4.4 (VIN); also elsewhere on the board
GND: C28.2, C29.2, C30.2, C32.2, C33.2, C34.2, R16.2, R19.2, U3.2 (GND), U4.2 (GND); also elsewhere on the board
unnamed: C27.2, R15.2, R16.1, U3.6 (FB)
unnamed: L1.1, U3.3 (SW)
unnamed: C31.2, R18.2, R19.1, U4.6 (FB)
unnamed: L2.1, U4.3 (SW)
PCIE_PWR_EN: U3.1 (EN); also elsewhere on the board

Notes on the sheet:
X7R, 10V+, 1206
470nH Isat >= 3A DCR < 40mOhm
X7R, 16V+, 0805
Rtop = Rbot((Vout / Vfb) - 1) = Rbot((3.3 / 0.6) - 1) = 4.5(Rbot)
Rtop = Rbot((Vout / Vfb) - 1) = Rbot((1.05 / 0.6) - 1) = 0.75(Rbot)

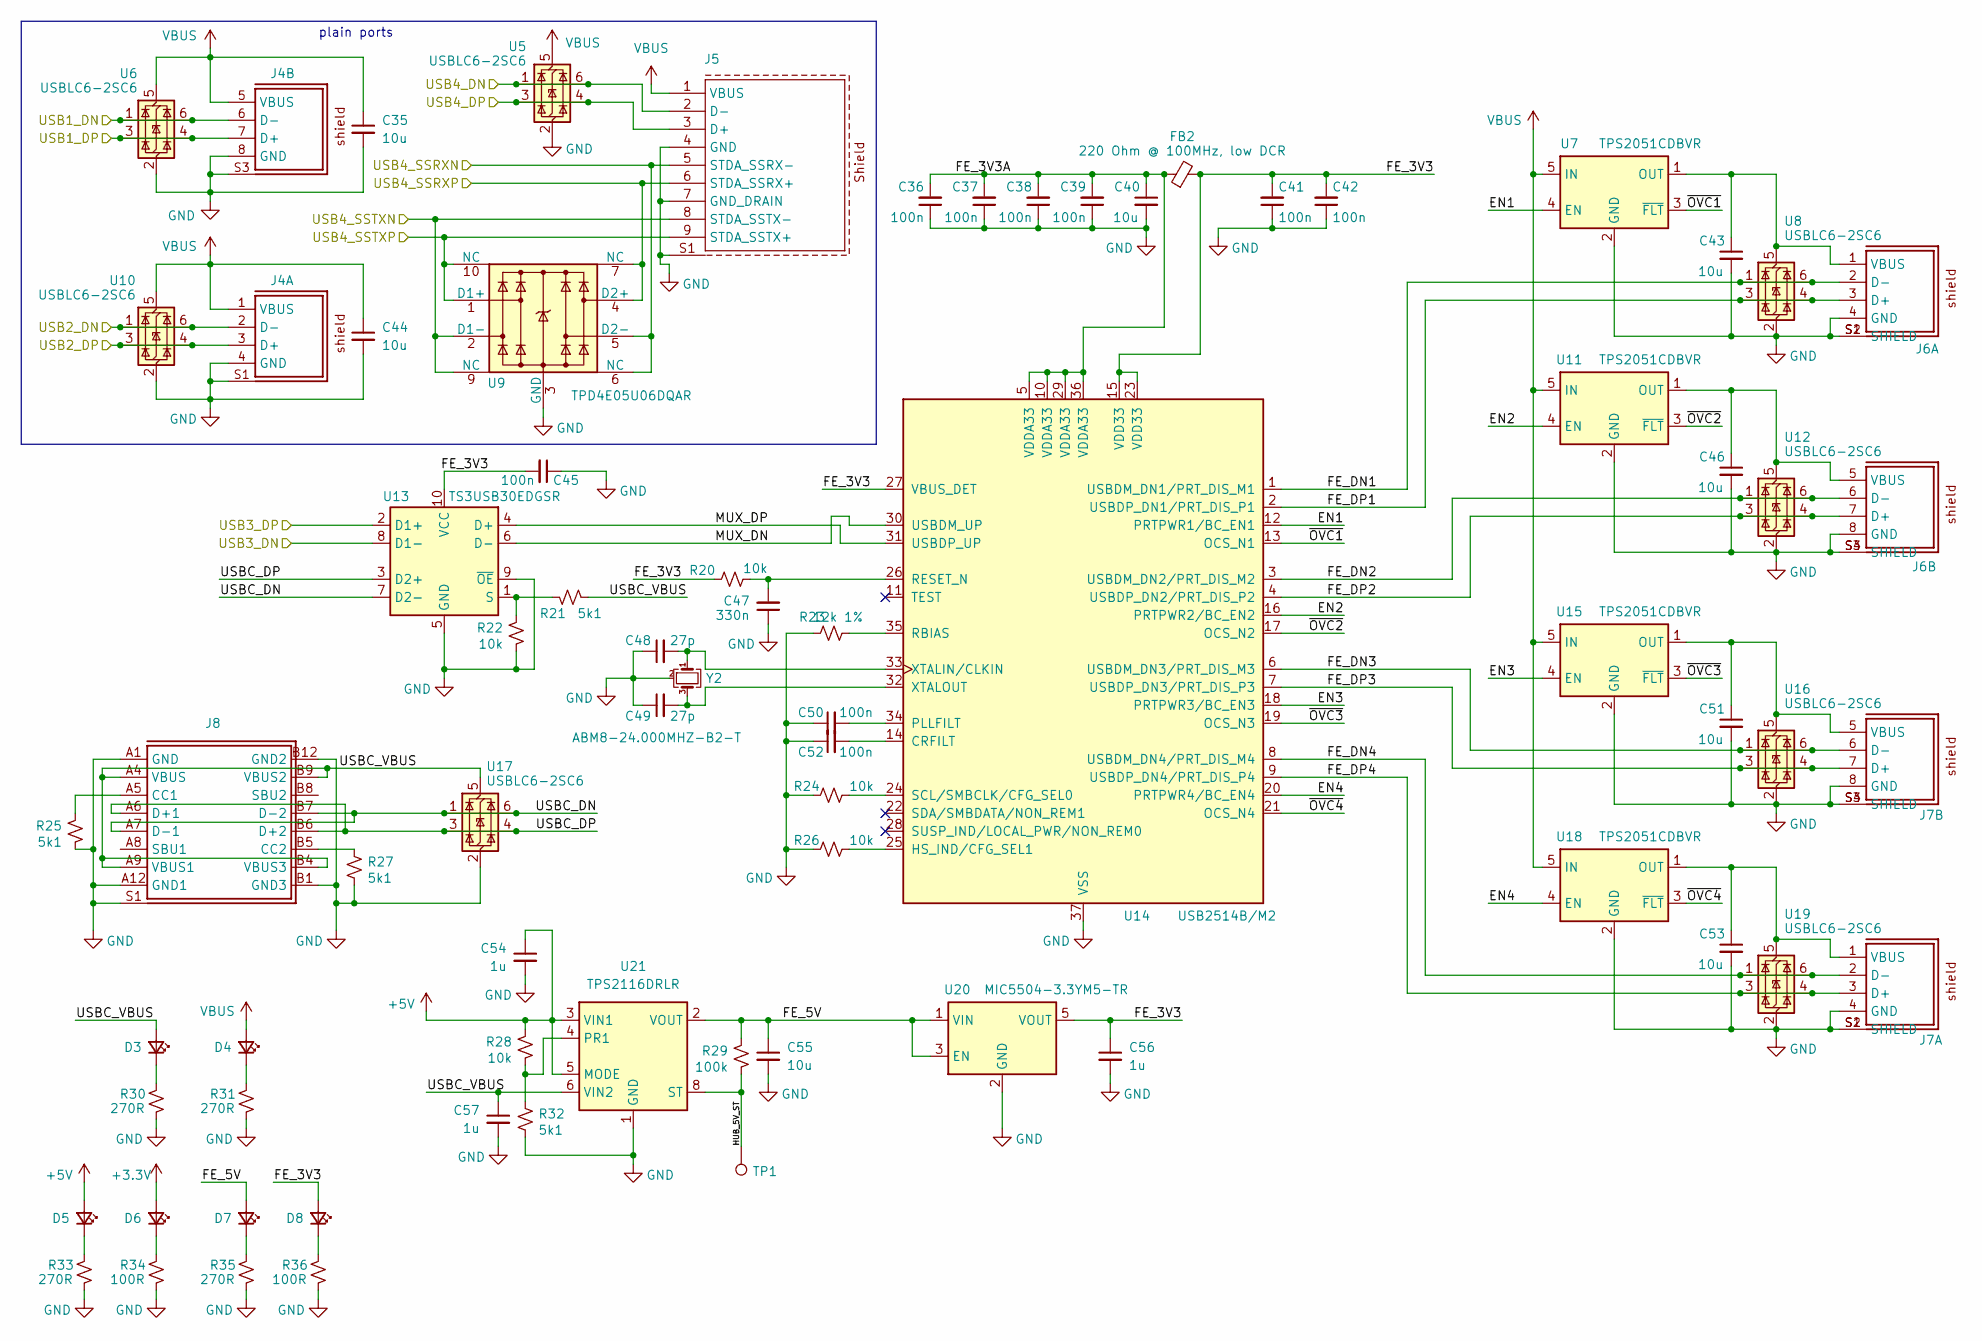
[picture p11: schematic usb.kicad_sch]

Parts:
C35, C40, C43, C44, C46, C51, C53, C55: 10u; C_0805_2012Metric; Part Number CC0805KRX5R8BB106
C36, C37, C38, C39, C41, C42, C45, C50, C52: 100n; C_0402_1005Metric; Part Number CC0402KRX7R8BB104
C47: 330n; C_0402_1005Metric; Part Number CC0402KPX5R6BB334
C48, C49: 27p; C_0402_1005Metric; Part Number CC0402JRNPO9BN270
C54, C56, C57: 1u; C_0603_1608Metric; Part Number CC0603KRX7R8BB105
D3, D4, D5, D6, D7, D8: Green; LED_0603_1608Metric; Part Number LTST-C190KGKT
FB2: 220 Ohm @ 100MHz, low DCR; L_0805_2012Metric; Part Number BLM21PG221SN1D
J4, J6, J7: USB-A-D-RA; J_Wurth_WR-USB_61400826021; Working Voltage (V (AC)) 30; Part Number USB-A-D-RA
J5: USB-A3-S-VT-CS5A; J_Wurth_WR-USB_692121430000; Working Voltage(V (AC)) 30 V (AC); Part Number USB-A3-S-VT-CS5A
J8: USB4085-GF-A; J_Wurth_WR-USB_629722000214; Working Voltage (V (AC)) 20; Part Number USB4085-GF-A
R20, R22, R24, R26, R28: 10k; R_0603_1608Metric; Part Number RC0603FR-0710KL
R21, R25, R27, R32: 5k1; R_0603_1608Metric; Part Number RC0603FR-075K1L
R23: 12k 1%; R_0603_1608Metric; Part Number RC0603FR-0712KL
R29: 100k; R_0603_1608Metric; Part Number RC0603FR-07100KL
R30, R31, R33, R35: 270R; R_0603_1608Metric; Part Number RC0603FR-07270RL
R34, R36: 100R; R_0603_1608Metric; Part Number RC0603FR-07100RL
TP1: TestPoint; TestPoint_Pad_1.0x1.0mm
U5, U6, U8, U10, U12, U16, U17, U19: USBLC6-2SC6; SOT-23-6; Part Number USBLC6-2SC6
U7, U11, U15, U18: TPS2051CDBVR; SOT-23-5; Part Number TPS2051CDBVR
U9: TPD4E05U06DQAR; USON-10_2.5x1.0mm_P0.5mm; Part Number TPD4E05U06DQAR
U13: TS3USB30EDGSR; TSSOP-10_3x3mm_P0.5mm; Part Number TS3USB30EDGSR
U14: USB2514B/M2; QFN-36-1EP_6x6mm_P0.5mm_EP3.7x3.7mm; Part Number USB2514B/M2
U20: MIC5504-3.3YM5-TR; SOT-23-5; Part Number MIC5504-3.3YM5-TR
U21: TPS2116DRLR; SOT-583-8; Part Number TPS2116DRLR
Y2: ABM8-24.000MHZ-B2-T; Crystal_SMD_3225-4Pin_3.2x2.5mm; Part Number ABM8-24.000MHZ-B2-T

Connections:
+3.3V: D6.2 (A); also elsewhere on the board
+5V: C54.1, D5.2 (A), R28.2, U21.3 (VIN1), U21.5 (MODE); also elsewhere on the board
/PCIe_USB/USB1_DN: J4.6 (D-), U6.1 (I/O1), U6.6 (I/O1); also elsewhere on the board
/PCIe_USB/USB1_DP: J4.7 (D+), U6.3 (I/O2), U6.4 (I/O2); also elsewhere on the board
/PCIe_USB/USB2_DN: J4.2 (D-), U10.1 (I/O1), U10.6 (I/O1); also elsewhere on the board
/PCIe_USB/USB2_DP: J4.3 (D+), U10.3 (I/O2), U10.4 (I/O2); also elsewhere on the board
/PCIe_USB/USB3_DN: U13.8 (D1-); also elsewhere on the board
/PCIe_USB/USB3_DP: U13.2 (D1+); also elsewhere on the board
/PCIe_USB/USB4_DN: J5.2 (D-), U5.1 (I/O1), U5.6 (I/O1); also elsewhere on the board
/PCIe_USB/USB4_DP: J5.3 (D+), U5.3 (I/O2), U5.4 (I/O2); also elsewhere on the board
/PCIe_USB/USB4_SSRXN: J5.5 (STDA_SSRX-), U9.5 (D2-), U9.6 (NC); also elsewhere on the board
/PCIe_USB/USB4_SSRXP: J5.6 (STDA_SSRX+), U9.4 (D2+), U9.7 (NC); also elsewhere on the board
/USB/EN1: U7.4 (EN), U14.12 (PRTPWR1/BC_EN1)
/USB/EN2: U11.4 (EN), U14.16 (PRTPWR2/BC_EN2)
/USB/EN3: U14.18 (PRTPWR3/BC_EN3), U15.4 (EN)
/USB/EN4: U14.20 (PRTPWR4/BC_EN4), U18.4 (EN)
/USB/FE_3V3: C41.2, C42.2, C45.2, C56.1, D8.2 (A), FB2.2, R20.2, U13.10 (VCC), U14.15 (VDD33), U14.23 (VDD33), U14.27 (VBUS_DET), U20.5 (VOUT)
/USB/FE_3V3A: C36.2, C37.2, C38.2, C39.2, C40.1, FB2.1, U14.5 (VDDA33), U14.10 (VDDA33), U14.29 (VDDA33), U14.36 (VDDA33)
/USB/FE_5V: C55.1, D7.2 (A), R29.2, U20.1 (VIN), U20.3 (EN), U21.2 (VOUT), U21.7 (VOUT)
/USB/FE_DN1: J6.2 (D-), U8.1 (I/O1), U8.6 (I/O1), U14.1 (USBDM_DN1/PRT_DIS_M1)
/USB/FE_DN2: J6.6 (D-), U12.1 (I/O1), U12.6 (I/O1), U14.3 (USBDM_DN2/PRT_DIS_M2)
/USB/FE_DN3: J7.6 (D-), U14.6 (USBDM_DN3/PRT_DIS_M3), U16.1 (I/O1), U16.6 (I/O1)
/USB/FE_DN4: J7.2 (D-), U14.8 (USBDM_DN4/PRT_DIS_M4), U19.1 (I/O1), U19.6 (I/O1)
/USB/FE_DP1: J6.3 (D+), U8.3 (I/O2), U8.4 (I/O2), U14.2 (USBDP_DN1/PRT_DIS_P1)
/USB/FE_DP2: J6.7 (D+), U12.3 (I/O2), U12.4 (I/O2), U14.4 (USBDP_DN2/PRT_DIS_P2)
/USB/FE_DP3: J7.7 (D+), U14.7 (USBDP_DN3/PRT_DIS_P3), U16.3 (I/O2), U16.4 (I/O2)
/USB/FE_DP4: J7.3 (D+), U14.9 (USBDP_DN4/PRT_DIS_P4), U19.3 (I/O2), U19.4 (I/O2)
/USB/HUB_5V_ST: R29.1, TP1.1 (1_1), U21.8 (ST)
/USB/MUX_DN: U13.6 (D-), U14.30 (USBDM_UP)
/USB/MUX_DP: U13.4 (D+), U14.31 (USBDP_UP)
/USB/USB4_SSTXN: J5.8 (STDA_SSTX-), U9.2 (D1-), U9.9 (NC); also elsewhere on the board
/USB/USB4_SSTXP: J5.9 (STDA_SSTX+), U9.1 (D1+), U9.10 (NC); also elsewhere on the board
/USB/USBC_DN: J8.A7 (D-1), J8.B7 (D-2), U13.7 (D2-), U17.1 (I/O1), U17.6 (I/O1)
/USB/USBC_DP: J8.A6 (D+1), J8.B6 (D+2), U13.3 (D2+), U17.3 (I/O2), U17.4 (I/O2)
/USB/USBC_VBUS: C57.1, D3.2 (A), J8.A4 (VBUS), J8.A9 (VBUS1), J8.B4 (VBUS3), J8.B9 (VBUS2), R21.1, U17.5 (VBUS), U21.6 (VIN2)
/USB/~OVC1: U7.3 (~FLT), U14.13 (OCS_N1)
/USB/~OVC2: U11.3 (~FLT), U14.17 (OCS_N2)
/USB/~OVC3: U14.19 (OCS_N3), U15.3 (~FLT)
/USB/~OVC4: U14.21 (OCS_N4), U18.3 (~FLT)
GND: C35.2, C36.1, C37.1, C38.1, C39.1, C40.2, C41.1, C42.1, C43.2, C44.2, C45.1, C46.2, C47.1, C48.1, C49.1, C50.1, C51.2, C52.1, C53.2, C54.2, C55.2, C56.2, C57.2, J4.4 (GND), J4.8 (GND), J4.S1, J4.S2, J4.S3, J4.S4, J5.4 (GND), J5.7 (GND_DRAIN), J5.S1, J5.S2 (SHIELD), J6.4 (GND), J6.8 (GND), J6.S1 (SHIELD), J6.S2 (SHIELD), J6.S3 (SHIELD), J6.S4 (SHIELD), J7.4 (GND), J7.8 (GND), J7.S1 (SHIELD), J7.S2 (SHIELD), J7.S3 (SHIELD), J7.S4 (SHIELD), J8.A1 (GND), J8.A12 (GND1), J8.B1 (GND3), J8.B12 (GND2), J8.S1, J8.S2, J8.S3, J8.S4, R22.1, R23.2, R24.2, R25.1, R26.2, R27.1, R30.1, R31.1, R32.1, R33.1, R34.1, R35.1, R36.1, U5.2 (GND), U6.2 (GND), U7.2 (GND), U8.2 (GND), U9.3 (GND), U9.8 (GND), U10.2 (GND), U11.2 (GND), U12.2 (GND), U13.5 (GND), U13.9 (~OE), U14.37 (VSS), U15.2 (GND), U16.2 (GND), U17.2 (GND), U18.2 (GND), U19.2 (GND), U20.2 (GND), U21.1 (GND), Y2.2 (G), Y2.4 (G); also elsewhere on the board
unnamed: D3.1 (K), R30.2
unnamed: D4.1 (K), R31.2
unnamed: D5.1 (K), R33.2
unnamed: D6.1 (K), R34.2
unnamed: D7.1 (K), R35.2
unnamed: D8.1 (K), R36.2
unnamed: C43.1, J6.1 (VBUS), U7.1 (OUT), U8.5 (VBUS)
unnamed: C46.1, J6.5 (VBUS), U11.1 (OUT), U12.5 (VBUS)
unnamed: C53.1, J7.1 (VBUS), U18.1 (OUT), U19.5 (VBUS)
unnamed: C51.1, J7.5 (VBUS), U15.1 (OUT), U16.5 (VBUS)
unnamed: J8.A5 (CC1), R25.2
unnamed: J8.B5 (CC2), R27.2
unnamed: R21.2, R22.2, U13.1 (S)
unnamed: C52.2, U14.14 (CRFILT)
unnamed: R26.1, U14.25 (HS_IND/CFG_SEL1)
unnamed: C50.2, U14.34 (PLLFILT)
unnamed: R23.1, U14.35 (RBIAS)
unnamed: C47.2, R20.1, U14.26 (RESET_N)
unnamed: R24.1, U14.24 (SCL/SMBCLK/CFG_SEL0)
unnamed: C48.2, U14.33 (XTALIN/CLKIN), Y2.1
unnamed: C49.2, U14.32 (XTALOUT), Y2.3
unnamed: R28.1, R32.2, U21.4 (PR1)
VBUS: C35.1, C44.1, D4.2 (A), J4.1 (VBUS), J4.5 (VBUS), J5.1 (VBUS), U5.5 (VBUS), U6.5 (VBUS), U7.5 (IN), U10.5 (VBUS), U11.5 (IN), U15.5 (IN), U18.5 (IN); also elsewhere on the board

Notes on the sheet:
plain ports

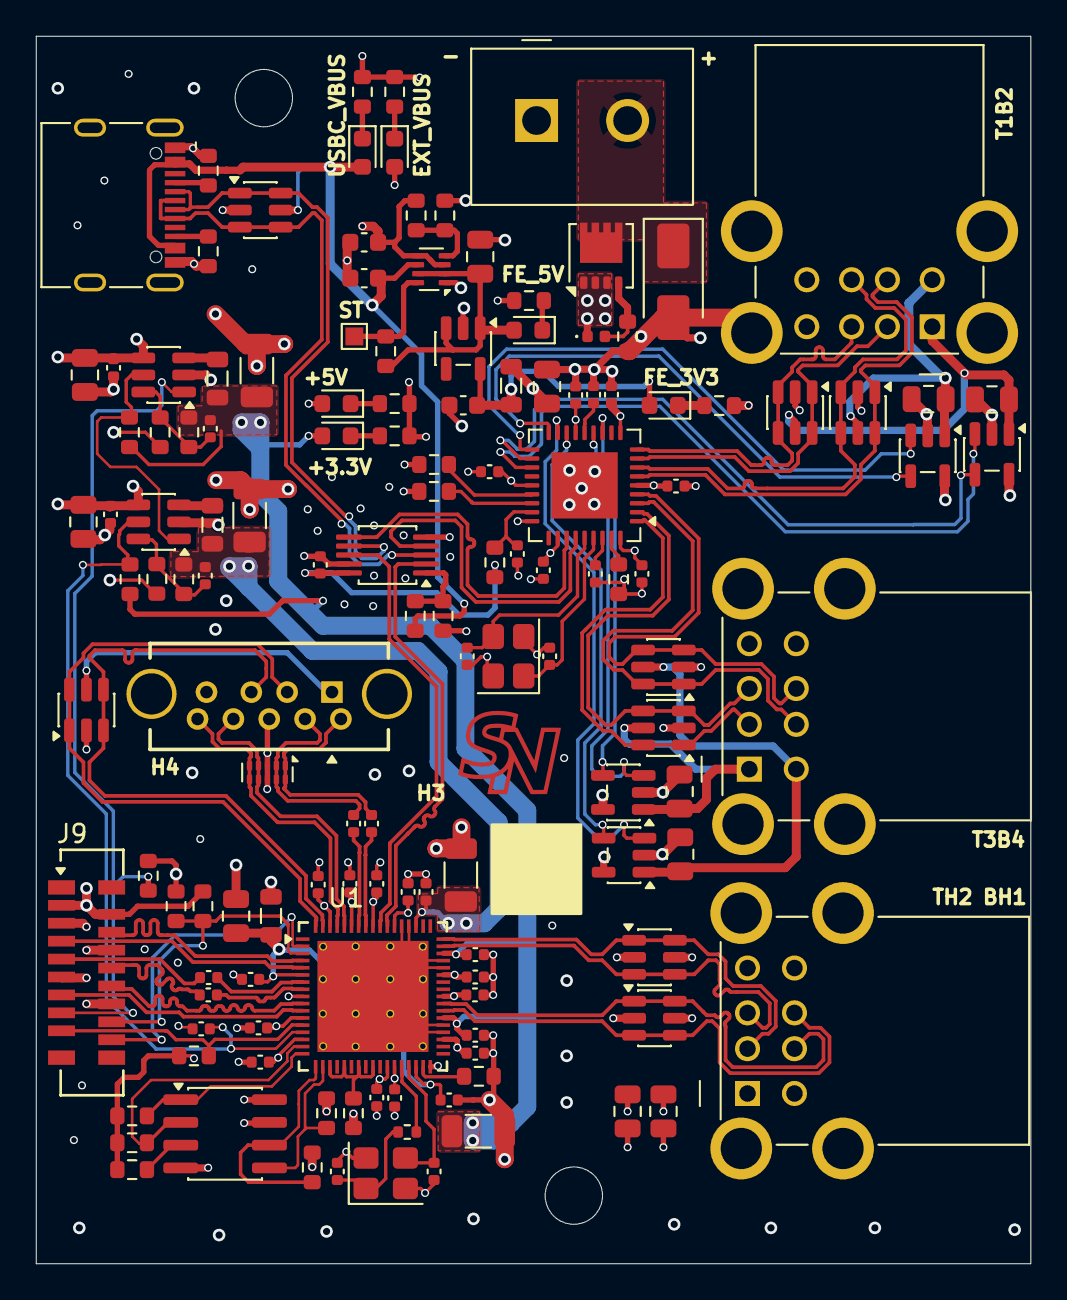
[picture p12: board rov_usb.kicad_pcb from above]

Board: 4 copper layers, 55.5 x 68.5 mm, 139 parts (0 on the bottom side), 97 nets.
