samnadol/ROV_PCIe_USB_HUB/ROV_PCIe_Adapter/ROV_PCIe_Adapter.kicad_pcb

## KiCad design ROV_PCIe_Adapter/ROV_PCIe_Adapter.kicad_pcb (2026-07-18)

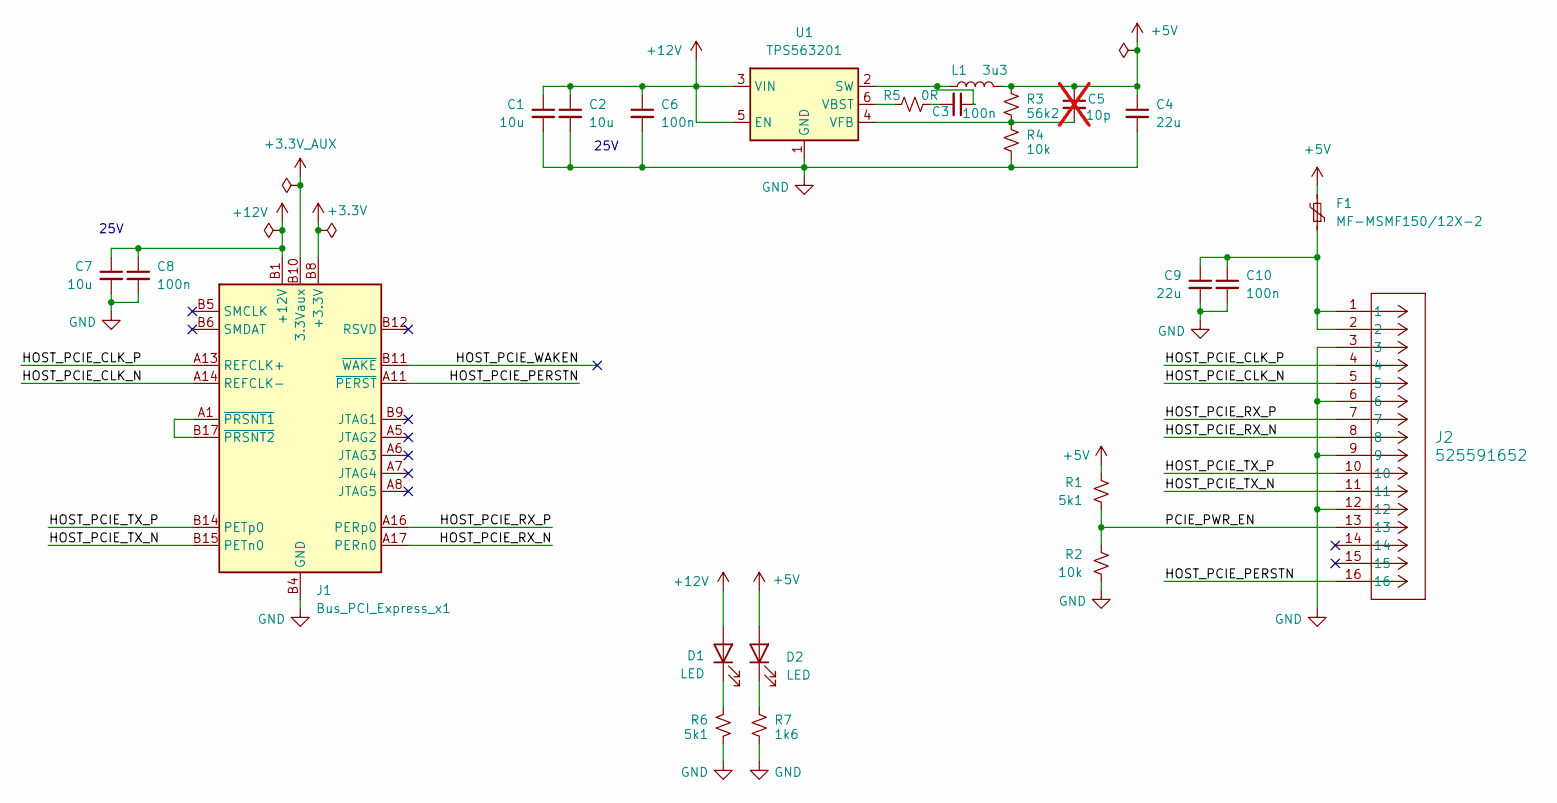
[picture p13: schematic ROV_PCIe_Adapter.kicad_sch]

Parts:
C1, C2, C7: 10u; C_0805_2012Metric; Voltage Rating 25; Part Number CC0805KRX5R8BB106
C3, C6, C8, C10: 100n; C_0402_1005Metric; Voltage Rating 25; Part Number CC0402KRX7R8BB104
C4, C9: 22u; C_1206_3216Metric; Voltage Rating 25; Part Number CC1206KKX5R8BB226
C5: 10p; C_0402_1005Metric; Part Number CL05A104KA5NNNC; not fitted
D1, D2: LED; LED_0603_1608Metric; Part Number LTST-C190KGKT
F1: MF-MSMF150/12X-2; Fuse_1812_4532Metric; Part Number MF-MSMF150/12X-2
J1: Bus_PCI_Express_x1; BUS_PCIexpress_x1
J2: 525591652; Part Number 525591652
L1: 3u3; L_Taiyo-Yuden_MD-5050; Part Number BWVC005050403R3M00
R1, R6: 5k1; R_0603_1608Metric; Part Number RC0603FR-075K1L
R2, R4: 10k; R_0603_1608Metric; Part Number RC0603FR-0710KL
R3: 56k2; R_0603_1608Metric; Part Number RC0603FR-0756K2L
R5: 0R; R_0402_1005Metric; Part Number RC0402JR-070RL
R7: 1k6; R_0603_1608Metric; Part Number RC0603FR-071K6L
U1: TPS563201; SOT-23-6; Part Number TPS563201DDCR

Connections:
+3.3V: J1.A9 (+3.3V), J1.A10 (+3.3V), J1.B8 (+3.3V)
+3.3V_AUX: J1.B10 (3.3Vaux)
+5V: C4.1, C5.1, D2.2 (A), F1.2, L1.2, R1.1, R3.1
+12V: C1.1, C2.1, C6.1, C7.1, C8.1, D1.2 (A), J1.A2 (+12V), J1.A3 (+12V), J1.B1 (+12V), J1.B2 (+12V), J1.B3 (+12V), U1.3 (VIN), U1.5 (EN)
/HOST_PCIE_CLK_N: J1.A14 (REFCLK-), J2.5
/HOST_PCIE_CLK_P: J1.A13 (REFCLK+), J2.4
/HOST_PCIE_PERSTN: J1.A11 (~PERST), J2.16
/HOST_PCIE_RX_N: J1.A17 (PERn0), J2.8
/HOST_PCIE_RX_P: J1.A16 (PERp0), J2.7
/HOST_PCIE_TX_N: J1.B15 (PETn0), J2.11
/HOST_PCIE_TX_P: J1.B14 (PETp0), J2.10
/HOST_PCIE_WAKEN: J1.B11 (~WAKE)
/PCIE_PWR_EN: J2.13, R1.2, R2.1
GND: C1.2, C2.2, C4.2, C6.2, C7.2, C8.2, C9.2, C10.2, J1.A4 (GND), J1.A12 (GND), J1.A15 (GND), J1.A18 (GND), J1.B4 (GND), J1.B7 (GND), J1.B13 (GND), J1.B16 (GND), J1.B18 (GND), J2.3, J2.6, J2.9, J2.12, R2.2, R4.2, R6.2, R7.2, U1.1 (GND)
unnamed: C3.2, R5.2
unnamed: C9.1, C10.1, F1.1, J2.1, J2.2
unnamed: D1.1 (K), R6.1
unnamed: D2.1 (K), R7.1
unnamed: J1.A1 (~PRSNT1), J1.B17 (~PRSNT2)
unnamed: C3.1, L1.1, U1.2 (SW)
unnamed: R5.1, U1.6 (VBST)
unnamed: C5.2, R3.2, R4.1, U1.4 (VFB)

Notes on the sheet:
25V

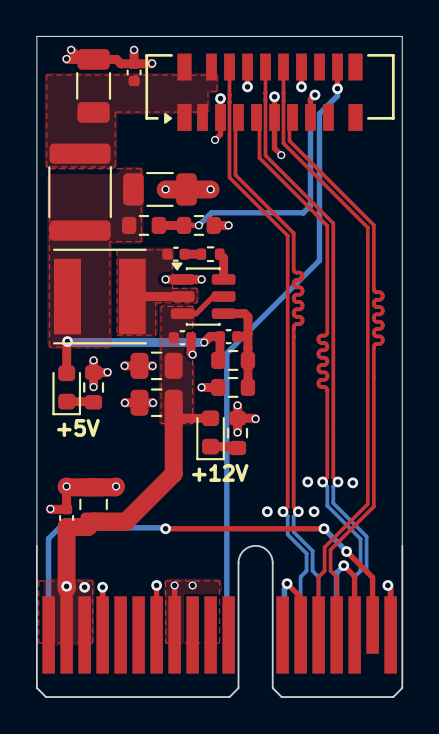
[picture p14: board ROV_PCIe_Adapter.kicad_pcb from above]

Board: 4 copper layers, 20.3 x 36.7 mm, 24 parts (0 on the bottom side), 20 nets.
