samnadol/ROV_PCIe_USB_HUB/(commit log)

2026-07-14 updates (fe1.1s board deprecated)
    [ROV_PCIe_Adapter.kicad_pcb, ROV_PCIe_Adapter.kicad_sch, bom.csv, rov_usb.kicad_pcb, usb.kicad_sch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]
2026-07-14 remove fe1.1s (outdated)
    [bom.csv, pcie_usb.kicad_sch, power.kicad_sch, rov_usb.kicad_pcb, rov_usb.kicad_sch, usb.kicad_sch]
2026-08-24 create final
    [rov_usb.kicad_sch]
2026-08-24 add final
    [ROV_PCIE_USB_HUB_FINAL.kicad_pcb, ROV_PCIE_USB_HUB_FINAL.kicad_sch]
2026-08-24 move parts to project specific libs
    [pcie_usb.kicad_sch, rov_usb.kicad_pcb, rov_usb.kicad_sch]
2026-08-31 embed 3d models
    [ROV_PCIE_USB_HUB_FINAL.kicad_pcb, rov_usb.kicad_pcb]
2026-09-04 add images, clean up
    [ROV_PCIE_USB_HUB_FINAL.kicad_pcb]
